e14121040-netizen/2026-NCKU-ME-PROJECT/取物機器人(八足Jansen)/README.md

# 取物機器人（八足 Theo Jansen）

> 本目錄包含八足 Theo Jansen 連桿取物機器人的全部資料。

## 系統架構

```
手機遙控 App（ESP32 內建藍牙）
    │
    ▼
ESP32（主控板，USB 插電腦供電）── 藍牙接收 + ESP-NOW 指令分發中心
    │
    ├── ESP-NOW ──→ ESP32-C3 #1（腿部子控板）
     │                 └── BTS7960 ×2 → JGB37-555 DC 12V 66rpm 直流減速馬達 ×2
     │                                 （左右側八足步行，原地旋轉轉向）
    │
    ├── ESP-NOW ──→ ESP32-C3 #2（RotatingArm 旋轉端）
    │                 ├── MG996R 360°（r 齒條伸縮，人眼判斷位置）
    │                 ├── MG996R 180°（夾爪 θ 旋轉）
    │                 ├── MG996R 180°（夾爪開合）
    │                 └── BTS7960 #4 → JGY370（z 方向升降，蝸桿自鎖）
    │
    └── ESP-NOW ──→ ESP32-C3 #3（FixedStage 固定端）
                      ├── BTS7960 #3 → XD-25GA 370（固定端 spin）
                      └── MG996R 180°（承物盒 Gate）

    電源（機器人上）：
    ├── 上半部 4S：C3 #2 + BTS7960 #4 + z 馬達 + 上方 Servo ×3
    └── 腿部 + FixedStage 4S：C3 #1/#3 + BTS7960 #1/#2/#3 + 腿部馬達 + 固定端 spin + Gate servo

    ESP32 主控板：USB 插電腦獨立供電（ESP-NOW 無線通訊）
```

透過 ESP-NOW 讓各個 ESP 控制板之間不需 Wi-Fi 即可做點對點通訊，在功能上設計模組化的系統。  
**主控板不直接驅動任何馬達**，僅負責藍芽指令接收與 ESP-NOW 指令分發，插電腦 USB 供電。

## 步行機構

- **類型**：Theo Jansen Linkage 八足（Spider Robot）
- **步態**：交替步態（Alternating Gait）— 同側每足相位差 90°，左右側錯開 180°
- **驅動**：左右各 1 顆 JGB37-555 DC 12V 66rpm 直流減速馬達，原地旋轉轉向（不做左右輪不同速轉彎，避免重心不穩）
- **控制**：由 ESP32-C3 #1（腿部子控板）透過 BTS7960 ×2 驅動
- **連桿參數**：Theo Jansen 11 Holy Numbers（縮放因子 0.7）

詳細連桿設計請見 → [TheoJansen連桿設計參考.md](機構設計/TheoJansen連桿設計參考.md)

## 八足配置

```
  俯視圖（↑ = 前進方向）

       前
  足1 ── 足5
   |      |
  足2 ── 足6     ← 機身
   |      |
  足3 ── 足7
   |      |
  足4 ── 足8
       後

  左側（足1~4）→ 馬達 A  ┐
  右側（足5~8）→ 馬達 B  ┘ 由 ESP32-C3 #1 控制
```

## 夾取機構

### 設計概念

- **座標系統**：採用圓柱座標系（r, θ, z），降低設計複雜度同時保留足夠的自由度
- **傳動方式**：齒輪、齒條與馬達控制
- **設計目標**：重量減輕，採用角度夾爪

### 自由度配置

| 自由度 | 驅動元件 | 控制方式 | 控制板 |
|---|---|---|---|
| **r（伸縮）** | MG996R 360° + 齒條 | 人眼判斷，按住伸出/縮回 | C3 #2 |
| **θ（旋轉）** | MG996R 180° | PWM 角度控制 | C3 #2 |
| **z（升降）** | JGY370 蝸桿馬達 | BTS7960 #4，蝸桿自鎖防滑 | C3 #2 |
| **FixedStage spin** | XD-25GA 370 | BTS7960 #3，自鎖 | C3 #3 |
| **夾爪開合** | MG996R 180° | PWM 角度控制 | C3 #2 |

### 機構規格

- **夾爪類型**：齒輪齒條雙向平行夾爪 (Rack and Pinion) — 平行版 + 止滑墊
- **設計參考**：
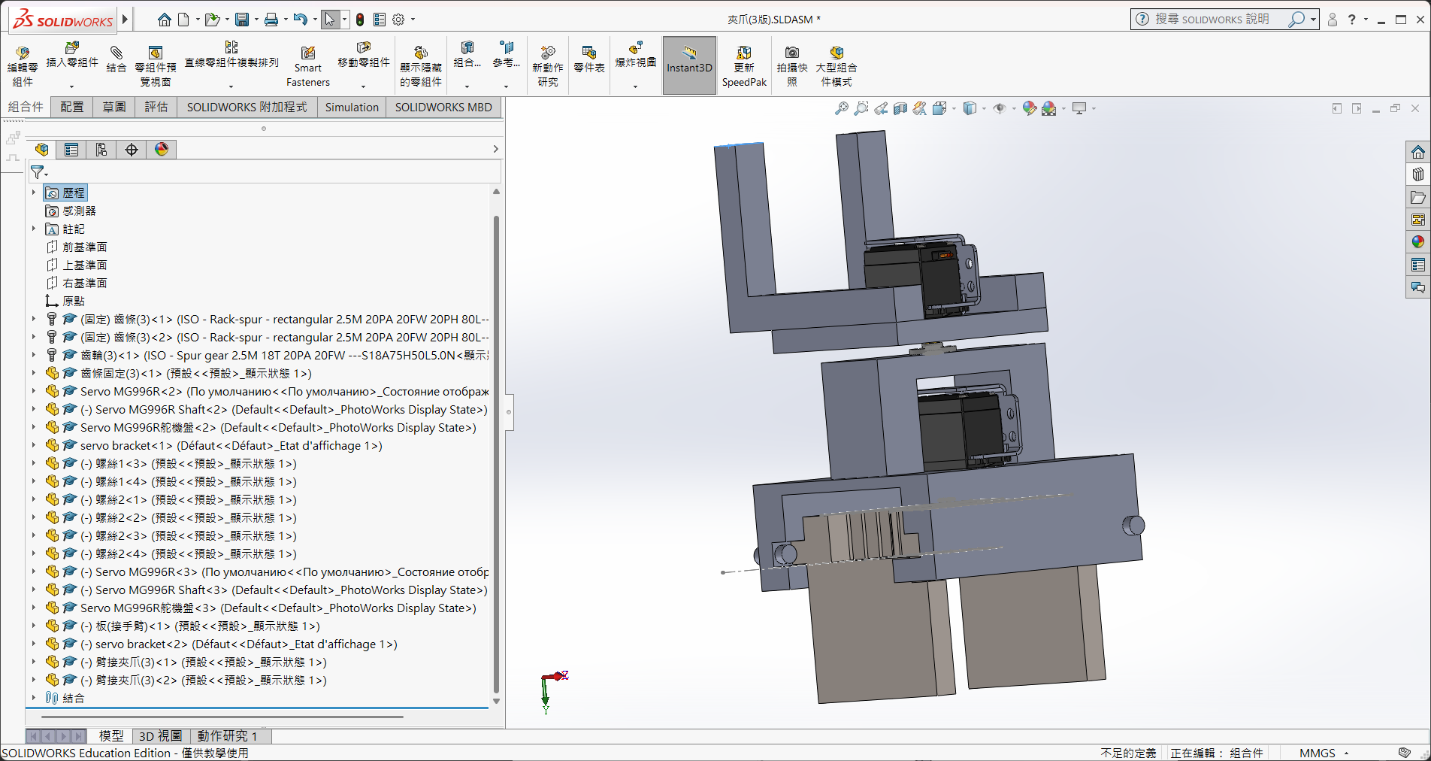
[picture p1: 取物機器人(八足Jansen)/夾爪/image.png]
夾爪設計圖1
  - 
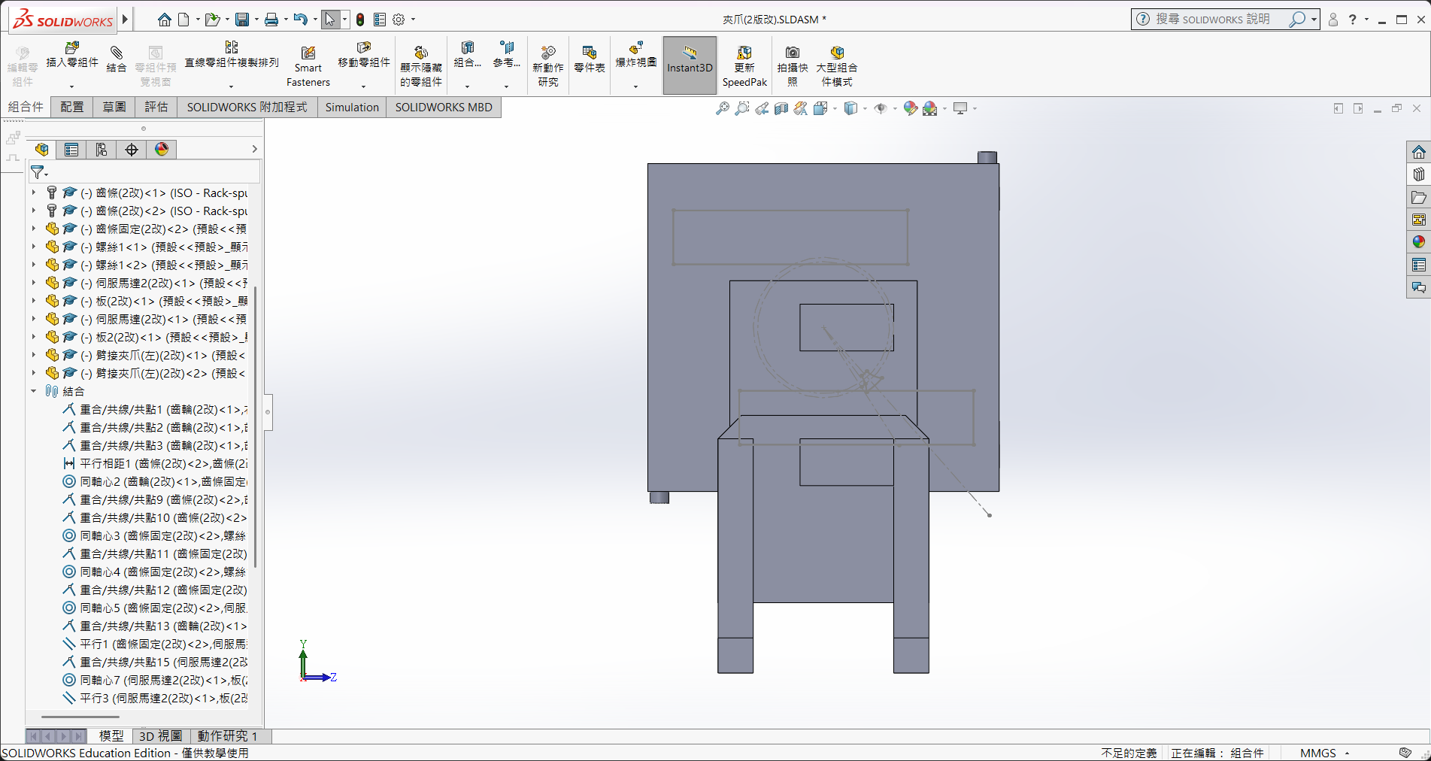
[picture p2: 取物機器人(八足Jansen)/夾爪/2026-03-14_003610.png]
夾爪設計圖2
  - 
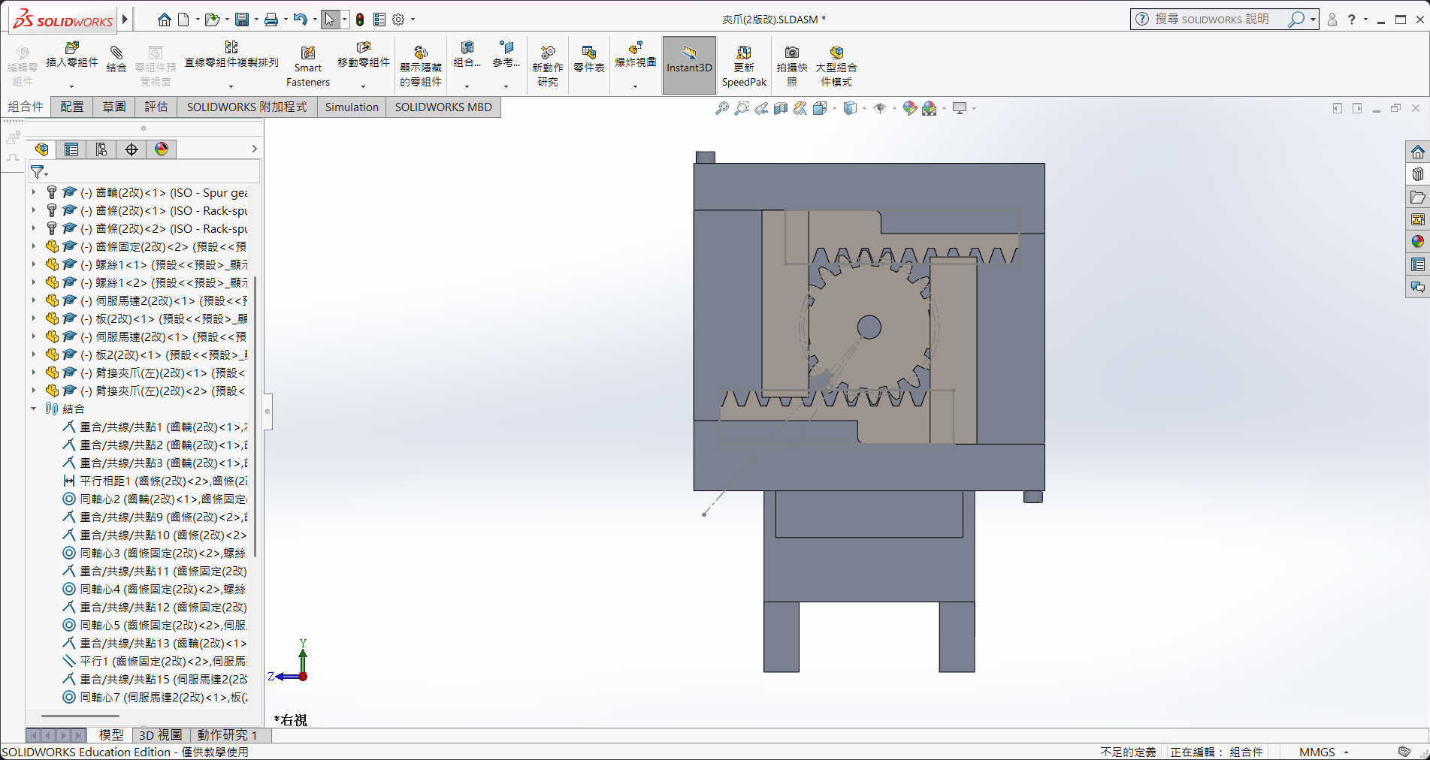
[picture p3: 取物機器人(八足Jansen)/夾爪/2026-03-14_003706.png]
夾爪設計圖3
  - 
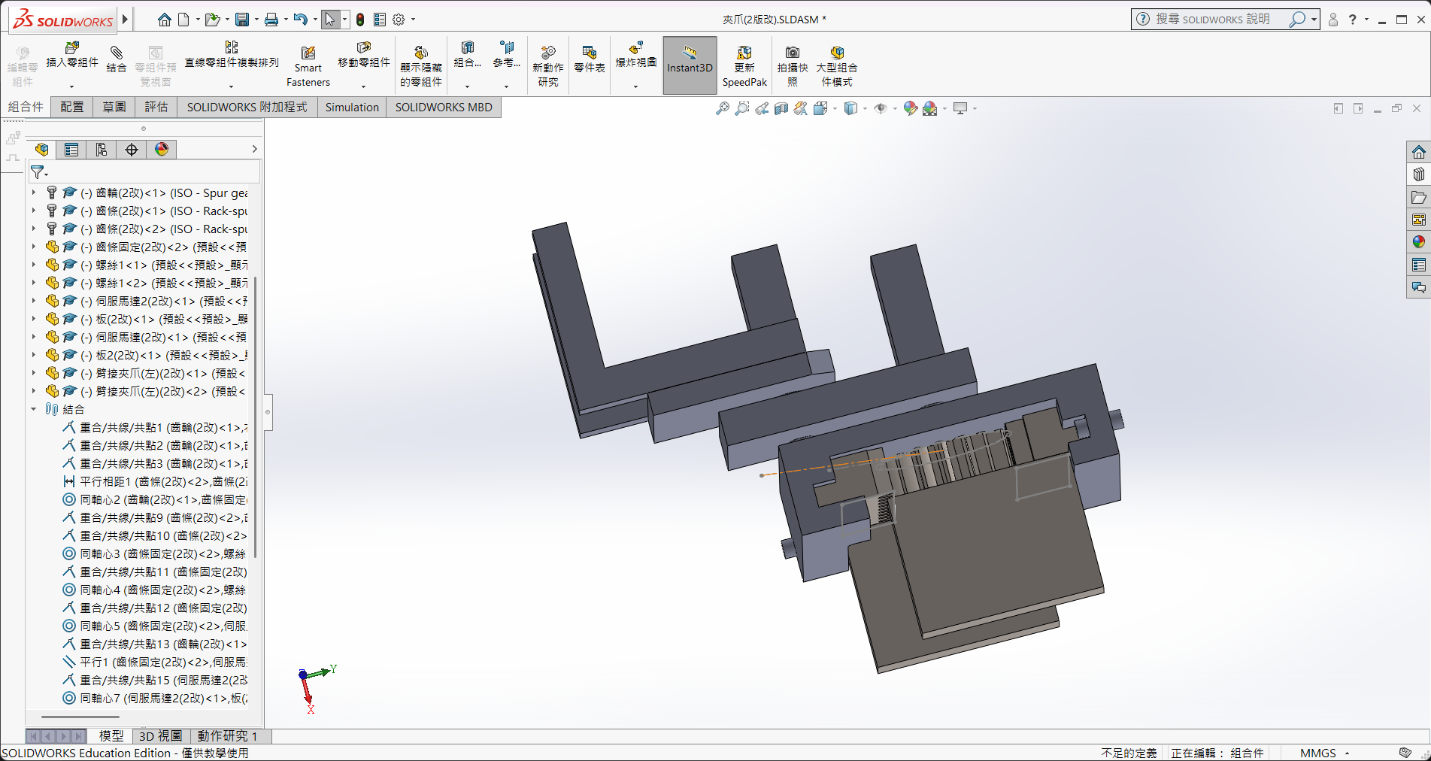
[picture p4: 取物機器人(八足Jansen)/夾爪/2026-03-14_003757.png]
夾爪設計圖4
  - 
- **機構設計**：
  - **夾爪本體**：使用 3D 列印製作夾爪板與溝槽板，齒輪採用壓克力雷射切割，齒條另外採購。
  - **r 方向伸縮**：MG996R 360° 連續旋轉舵機驅動齒條，搭配直線滑軌導引。
  - **固定端 spin**：固定端暫存盒 / 平台由 XD-25GA 370 驅動，提供 right/left 旋轉。
- **驅動設計**：
  - **r 伸縮**（C3 #2）：MG996R 360° 驅動齒條，操作員人眼判斷位置，按住按鈕伸出/縮回、放開停止。軟體超時保護（5 秒）防止過行程。
  - **θ 旋轉**（C3 #2）：MG996R 180° 標準伺服，精確角度控制。
  - **z 方向升降**（C3 #2）：JGY370 蝸桿減速馬達，由 BTS7960 #4 控制正反轉。蝸桿自鎖，斷電不會下滑。
  - **FixedStage spin**（C3 #3）：XD-25GA 370 自鎖馬達，由 BTS7960 #3 控制正反轉。
  - **夾爪開合**（C3 #2）：MG996R 180° 標準伺服，由 C3 GPIO PWM 直接驅動。
  - **安全保護機制**：軟體設有 Maximum Timeout（最大通電時間，預設 5 秒）保護，超時自動停止馬達，防止過行程或卡死燒毀。
- **貨架高度限制**：置物盤底部 156mm、邊框高 200mm → 手臂需伸入此高度。
- **夾取物限制**：最重零件為線性襯套 83.3g、最大外徑 32mm → 夾爪開口需大於 32mm，且馬達扭力需能支撐。

## 整體結構

- **分兩層設計**：
  - 上層：夾爪 + 機械手臂
  - 下層：承物台（堆高機）— 用於暫存取下的零件
- **承物台**：可傾斜式（一側絞鏈、一側伸縮桿），由 ESP32-C3 #3 的伺服馬達控制
- **承物盒擋板**：MG996R 180° 旋轉門式擋板，由 C3 #3 GPIO 5 控制開合
- **目標**：希望一次處理兩筆訂單（取多個零件後一次傾倒）

## 目錄結構

```
取物機器人(八足Jansen)/
├── README.md              ← 本文件
├── BOM.md                 ← 零件清單與預算
├── app_inventor/
│   ├── App指令對照表.md    ← 藍芽指令對照
│   └── AppInventor開發指南.md ← App 開發教學
├── 電控/
│   ├── 接線圖.md          ← 完整接線參考（含線材規格）
│   ├── 電源預算.md        ← 電流計算、電池續航、線材載流量
│   └── 電控組裝SOP.md     ← 分步組裝流程與驗證檢查點
├── 機構設計/
│   └── TheoJansen連桿設計參考.md  ← 連桿理論與尺寸
└── 夾爪/                  ← 夾爪設計圖片
```

> **ESP32 控制程式**統一放在 [`../esp32控制/`](../esp32控制/README.md)

## 快速開始

1. 閱讀 [BOM.md](BOM.md) 確認零件
2. 閱讀 [電控/接線圖.md](電控/接線圖.md) 完成接線
3. 閱讀 [esp32控制/README.md](../esp32控制/README.md) 了解程式架構與上傳流程
4. 上傳 ESP32 主控程式（`01_MainController`）
5. 上傳 ESP32-C3 子控板程式（`02_LegController` / `03_TurntableZController` / `04_ServoClawController`）
6. 設定 ESP32 藍芽遙控 App（參考 [App指令對照表](app_inventor/App指令對照表.md)）
7. 測試 ESP-NOW 三路通訊與步行、手臂、夾爪控制

## 藍芽指令速查

### 腿部指令（→ C3 #1）

| 指令 | 功能 | 指令 | 功能 |
|---|---|---|---|
| `f` | 前進 | `F` | 半速前進 |
| `b` | 後退 | `B` | 半速後退 |
| `l` | 原地左旋 | `L` | 半速左旋 |
| `r` | 原地右旋 | `R` | 半速右旋 |
| `q` | 原地左旋 | `e` | 原地右旋 |
| `0` | 全部停止 | | |

> ⚠ `l`/`r` 與 `q`/`e` 功能相同（皆為原地旋轉），不做左右輪不同速轉彎以避免重心不穩。

### RotatingArm 指令（→ C3 #2）

| 指令 | 功能 | 指令 | 功能 |
|---|---|---|---|
| `w` | r 齒條伸出 | `s` | r 齒條縮回 |
| `x` | r 齒條停止 | `h` | 歸位 |
| `i` | θ 旋轉（正） | `k` | θ 旋轉（反） |
| `o` | 夾爪張開 | `p` | 夾爪閉合 |
| `u` | z 上升 | `j` | z 下降 |

### FixedStage 指令（→ C3 #3）

| 指令 | 功能 | 指令 | 功能 |
|---|---|---|---|
| `a` | 固定端 spin left | `d` | 固定端 spin right |
| `g` | 擋板打開 | `n` | 擋板關閉 |

> 詳細指令協議請見 → [esp32控制/README.md](../esp32控制/README.md)
