e14121040-netizen/2026-NCKU-ME-PROJECT/開發步驟指南.md

# 開發步驟指南 — 機器人專題

> 本文件是整個專案的 **開發流程指南**。  
> 按照以下 8 個階段逐步完成，每個階段都有明確的步驟和驗收標準。

---

## 階段 0：環境準備與採購

### 目標
確保所有軟體已安裝、零件已到貨。

### 步驟

1. **安裝開發環境**
   | 軟體 | 用途 | 下載連結 |
   |------|------|----------|
   | Arduino IDE 2.x **或** PlatformIO | 取物機器人 ESP32 程式 | [Arduino IDE](https://www.arduino.cc/en/software) / [PlatformIO](https://platformio.org/) |
   | BLE Controller – Arduino ESP32 | 遙控 App | 取物機器人正式手機控制端 |
   | VS Code + EV3 MicroPython 擴充 | EV3 程式 | [pybricks.com](https://pybricks.com/ev3-micropython/) |
   | Python 3 + matplotlib | 連桿可視化 | `pip install matplotlib numpy` |
   | SolidWorks / Fusion 360 | 3D 建模 | 學校授權版 |

2. **安裝 ESP32 開發環境**
   - **Arduino IDE**：工具 → 開發板管理員 → 搜尋 `ESP32` → 安裝 Espressif Systems ESP32 Board
   - **PlatformIO**：安裝 PlatformIO IDE 擴充 → 建立 ESP32 專案
   - 需安裝：
   - `WiFi`、`esp_now`（ESP-NOW 通訊，已內建）
   - `BluetoothSerial`（藍芽序列通訊，已內建）
   - `ESP32Servo`（ESP32-C3 #3 伺服馬達控制，需安裝）

3. **採購零件**
   參考 BOM 清單：
   - 取物機器人 → [`取物機器人(八足Jansen)/BOM.md`](取物機器人(八足Jansen)/BOM.md)
   - 運輸機器人 → [`運輸機器人(EV3)/BOM.md`](運輸機器人(EV3)/BOM.md)

4. **準備學長的參考資料**
   - `歷屆學長資料(2021屆)/` 中有學長的 `.aia`（App 原始檔）和 `.ino`（Arduino 程式）
   - 優先閱讀學長的 App 截圖，了解 UI 佈局

### ✅ 驗收標準
- [ ] 所有軟體安裝完成，Arduino IDE 或 PlatformIO 能正常編譯 ESP32 程式
- [ ] BOM 上的零件都已到貨或確認供貨中
- [ ] 學長的 `.aia` 已下載並可在 App Inventor 中開啟

---

## 階段 1：取物機器人 — 底盤機構加工

### 目標
完成八足 Theo Jansen 連桿底盤的實體加工與組裝。

### 前置條件
- 零件已到貨（壓克力板、M3 螺絲、軸承/墊圈）
- 已閱讀 [`TheoJansen連桿設計參考.md`](取物機器人(八足Jansen)/機構設計/TheoJansen連桿設計參考.md)

### 步驟

1. **確認連桿參數**
   - 參考 [`TheoJansen連桿設計參考.md`](取物機器人(八足Jansen)/機構設計/TheoJansen連桿設計參考.md)
   - 確認最終參數：**Theo Jansen 11 Holy Numbers × 縮放因子 0.7**

2. **SolidWorks 繪製連桿片 2D 圖**
   - 畫出曲柄、連桿、搖桿的 2D 輪廓
   - 標注所有孔位（M3 孔徑 3.2mm）
   - 匯出 DXF 供雷射切割

3. **繪製機身底盤**
   - 底盤長 ≈ 280mm、寬 ≈ 260mm
   - 預留馬達座孔位（2 顆直流馬達）
   - 預留手臂底座安裝孔

4. **雷射切割壓克力**
   - 連桿片：3mm 壓克力
   - 底盤：5mm 壓克力（或鋁板）
   - 每面各切 4 組（共 8 足，Theo Jansen 每足多桿件，連桿片數量較多）

5. **組裝八足底盤**
   - 用 M3 螺絲 + 尼龍墊圈當軸銷
   - 先裝一側 4 足，確認轉動順暢
   - 再裝另一側 4 足
   - 同側每足曲柄相位差 90°，左右側錯開 180°（交替步態）

6. **手搖測試**
   - 手動旋轉曲柄，觀察足端軌跡
   - 確認 8 足同步性良好、無卡死

### ✅ 驗收標準
- [ ] 8 足底盤已組裝完成，可手搖運動
- [ ] 足端軌跡為平滑步行路徑（著地段近似直線），確認 Theo Jansen 機構正確
- [ ] 機體尺寸在 400×400mm 限制內

---

## 階段 2：取物機器人 — 電控接線與基礎測試

### 目標
完成所有電路接線，驗證 ESP-NOW 三路通訊與馬達基本功能。

### 前置條件
- 底盤機構已組裝完成（階段 1）
- ESP32 ×1、ESP32-C3 ×3、BTS7960 ×4、XL4015 ×2、LM2596 ×2、電池等零件到貨

> 📋 完整組裝流程請參考 → [`電控/電控組裝SOP.md`](取物機器人(八足Jansen)/電控/電控組裝SOP.md)  
> 📋 電源計算請參考 → [`電控/電源預算.md`](取物機器人(八足Jansen)/電控/電源預算.md)  
> 📋 接線參考 → [`電控/接線圖.md`](取物機器人(八足Jansen)/電控/接線圖.md)

### 步驟 2.1：降壓模組校準

**操作**：
1. 電池盒裝好 4 顆 18650，用三用電表量測電池盒輸出（應為 14~16.8V）
2. 分別接上半部 4S → XL4015-UpperServo、腿部 + FixedStage 4S → XL4015-Gate，**輸出端不接任何負載**
3. 上電，用三用電表量兩顆 XL4015 輸出，轉電位器調至 **5.0V ± 0.1V**
4. 斷電，在兩顆 XL4015 輸出端各焊上 1000μF 電解電容（注意正負極）+ 100nF 陶瓷電容
5. 重複以上步驟校準 LM2596-LegFixed 與 LM2596-Upper 至 5.0V

**驗證**：
- [ ] 電池盒電壓 14.0~16.8V
- [ ] XL4015-UpperServo / XL4015-Gate 輸出 4.9~5.1V（空載）
- [ ] LM2596 輸出 4.9~5.1V（空載）

> ⚠ 電位器通常需要轉很多圈。逆時針降壓、順時針升壓（依型號不同可能相反，看電表讀數調整）。

---

### 步驟 2.2：MCU 供電與上電驗證

**前置**：步驟 2.1 降壓模組已校準

**操作**：
1. LM2596-LegFixed 5V 輸出 → ESP32-C3 #1/#3 的 5V pin（用 24AWG 或杜邦線）
2. LM2596-Upper 5V 輸出 → ESP32-C3 #2 的 5V pin（用 24AWG 或杜邦線）
3. LM2596-LegFixed GND → C3 #1/#3 GND；LM2596-Upper GND → C3 #2 GND
4. 上電，觀察 C3 板載 LED 是否亮起
5. 逐一用 USB 線接電腦，開 Serial Monitor 確認有輸出

**驗證**：
- [ ] 3 塊 C3 板載 LED 正常亮起
- [ ] 腿部 + FixedStage 組內 GND 共地、上半部組內 GND 共地；兩組電源正極沒有互接
- [ ] Serial Monitor 可收到輸出（確認 USB CDC On Boot: Enabled）

---

### 步驟 2.3：取得 MAC 地址並配置

**操作**：
1. 將 `esp32控制/00_macaddress/` 上傳至每塊 C3（一塊一塊來）
2. 記錄 3 塊 C3 的 MAC 地址
3. 打開 `01_MainController.ino`，將 MAC 填入對應欄位：
   ```cpp
   uint8_t Leg_Address[]        = {0x__, 0x__, 0x__, 0x__, 0x__, 0x__};  // C3 #1
   uint8_t turntableZ_Address[] = {0x__, 0x__, 0x__, 0x__, 0x__, 0x__};  // C3 #2
   uint8_t servoClaw_Address[]  = {0x__, 0x__, 0x__, 0x__, 0x__, 0x__};  // C3 #3
   ```

**驗證**：
- [ ] 3 個 MAC 已記錄且填入 MainController 原始碼
- [ ] MAC 格式正確（6 個 0x__ 的 byte）

---

### 步驟 2.4：C3 #1 腿部馬達接線與獨立測試

**前置**：步驟 2.2 C3 已可上電

**操作**：
1. 電池 → BTS7960 #1/#2 (B+/B-)，確認 R_EN/L_EN 已接 3.3V
2. C3 #1 GPIO → BTS7960 #1/#2（RPWM/LPWM），參考接線圖
3. BTS7960 #1 M+/M- → JGB37-555 DC 12V 66rpm 左馬達，BTS7960 #2 M+/M- → 右馬達
4. 上傳 `02_LegController.ino` 至 C3 #1
5. Serial Monitor 測試：`f`(前進) → `b`(後退) → `l`(原地左旋) → `r`(原地右旋) → `0`(停止)
6. 如果馬達方向反了，交換 BTS7960 M+/M- 的兩條馬達線

**驗證**：
- [ ] 前進時兩馬達同向正轉
- [ ] 後退時兩馬達同向反轉
- [ ] 原地左旋/右旋正確（左反右正/左正右反）
- [ ] `+`/`-` 可調速，`0` 可停止

> 常見問題：馬達不轉 → 99% 是 BTS7960 R_EN/L_EN 未接 3.3V。

---

### 步驟 2.5：C3 #2 旋轉端 RotatingArm 接線與獨立測試

**操作**：
1. C3 #2 裝在旋轉端上方機構，控制 r 齒條、θ、夾爪與 z 升降。
2. C3 #2 GPIO 0/1/5 → 上方 Servo ×3 信號線；GPIO 3/4 → BTS7960 #4（z 升降 RPWM/LPWM）。
3. BTS7960 #4 M+/M- → JGY370（z 升降）。
4. 上傳 `03_RotatingArmController.ino` 至 C3 #2。
5. Serial 測試：`w`(r 伸) → `s`(r 縮) → `x`(r 停) → `i`/`k`(θ) → `o`/`p`(爪) → `u`(z 升) → `j`(z 降) → `0`(停)。
5. 輸入 `?` 查看狀態

**驗證**：
- [ ] r 齒條伸縮正常，`RSTOP` 只停止 r 齒條
- [ ] θ 與夾爪 Servo 正常
- [ ] z 升降正常，蝸桿自鎖（斷電不下滑）
- [ ] 持續運轉 5 秒後超時保護觸發
- [ ] 跨旋轉中心的供電線有鬆弛線圈與 strain relief

---

### 步驟 2.6：C3 #3 固定端 FixedStage 接線與獨立測試

**操作**：
1. C3 #3 留在固定端 / 暫存盒側。
2. C3 #3 GPIO 0/1 → BTS7960 #3（固定端 spin RPWM/LPWM）。
3. BTS7960 #3 M+/M- → XD-25GA 370（固定端 spin right/left）。
4. C3 #3 GPIO 5 → Gate servo 信號線；Gate servo V+ 從 XL4015-Gate 5V 取電。
5. 上傳 `04_FixedStageController.ino` 至 C3 #3。
6. Serial 測試：`a`(spin left) → `d`(spin right) → `g`(Gate open) → `n`(Gate close) → `0`(停)。

**驗證**：
- [ ] 固定端 spin 左右轉正常，方向正確
- [ ] Gate Open / Close 正常，Open 後短暫保持再釋放 PWM
- [ ] Gate Close 後 PWM 維持輸出，零件推擠時不會被打開
- [ ] `0` 可停止固定端 spin 與 Gate
- [ ] spin 持續運轉 5 秒後超時保護觸發

> ⚠ Gate servo 供電不足會導致抖動或嗡嗡聲。確認 XL4015-Gate 輸出穩定 5V，且 GND 與 C3 #3 / 腿部 + FixedStage 共地。

---

### 步驟 2.7：主控板 ESP-NOW + BLE 測試

**前置**：步驟 2.3 MAC 已填入，步驟 2.4~2.6 子控板已通過獨立測試

**操作**：
1. 上傳 `01_MainController.ino` 至 ESP32 主控板（USB 接電腦）；Arduino IDE 的 `Partition Scheme` 選 `Huge APP`，CLI 使用 `esp32:esp32:esp32:PartitionScheme=huge_app`
2. 開 Serial Monitor，確認 `Peer added: C3#1 Leg` 等三行輸出
3. Serial 輸入 `f` → 觀察 C3 #1 馬達前進
4. Serial 輸入 `u` → 觀察 C3 #2 z 上升
5. Serial 輸入 `w` → 觀察 C3 #2 齒條伸出
6. Serial 輸入 `a` → 觀察 C3 #3 固定端 spin left
7. Serial 輸入 `0` → 觀察三路全停
8. 手機搜尋 BLE 裝置 `ESP32_MainController` 並連線
9. 用手機 App 發送指令，確認三路回應

**驗證**：
- [ ] ESP-NOW 三路 Peer 全部加入成功
- [ ] 腿部/RotatingArm/FixedStage 三路指令都能正確轉發
- [ ] `0` 全停指令同時停止三路
- [ ] BLE 連線穩定
- [ ] BLE 斷線時自動急停

> 偵錯：如果 ESP-NOW 不通，參考 [`esp32控制/README.md`](esp32控制/README.md) 的「ESP-NOW 通訊偵錯」章節。

---

### 步驟 2.8：全系統聯調

**操作**：
1. 用 App 同時操作步行 + 手臂動作，確認不互相干擾
2. 連續操作 5 分鐘，觀察穩定性
3. 量測電池電壓（操作後應 > 13V）
4. 觸摸 BTS7960 散熱片，確認 < 40°C
5. 記錄任何異常現象

**驗證**：
- [ ] 步行 + 手臂可同時操作
- [ ] ESP-NOW 三路延遲 < 0.5 秒
- [ ] 無突然斷電或 MCU 重啟
- [ ] BTS7960 溫度合理
- [ ] 電池續航 > 15 分鐘

### ✅ 階段 2 總驗收標準
- [ ] C3 #1 腿部：步行馬達前進/後退/原地旋轉均正常
- [ ] C3 #2 RotatingArm：r 齒條、θ、夾爪、z 升降動作正常，超時保護有效
- [ ] C3 #3 FixedStage：固定端 spin 與 Gate 均正常，超時保護有效
- [ ] XL4015-UpperServo / XL4015-Gate / LM2596-LegFixed / LM2596-Upper 輸出穩定 5.0V
- [ ] ESP-NOW 三路通訊穩定，指令延遲 < 0.5 秒
- [ ] BLE 藍芽連線穩定
- [ ] 電池續航 > 15 分鐘

---

## 階段 3：取物機器人 — App 遙控

### 目標
完成手機遙控 App，可控制步行、RotatingArm 與 FixedStage（透過主控板 ESP-NOW 分發）。

### 前置條件
- ESP-NOW 三路通訊已成功測試（階段 2）

### 步驟

1. **配置 BLE Controller – Arduino ESP32**
   - 正式手機控制端使用 **BLE Controller – Arduino ESP32**
   - 連線目標為 BLE 裝置 `ESP32_MainController`
   - 介面包含：
     - **步行控制區**：`FORWARD` / `BACKWARD` / `LEFT` / `RIGHT` / `LEGSTOP`（→ C3 #1）
     - **旋轉端上方機構區**：`UP` / `DOWN` / `EXTEND` / `RETRACT` / `RSTOP` / `THETA+` / `THETA-` / `OPEN` / `CLOSE` / `HOME` / `ARMSTOP`（→ C3 #2）
     - **固定端暫存盒 / spin 區**：`TL` / `TR` / `GATEOPEN` / `GATECLOSE` / `FIXEDSTOP`（→ C3 #3）
     - **全域急停**：`STOP`

2. **測試 App**
   - 腿部動作後以 `LEGSTOP` 驗證只停止 C3 #1
   - 旋轉端動作後以 `ARMSTOP` 驗證只停止 C3 #2（舊 App 的 `TZSTOP` / `SERVOSTOP` 也會停 C3 #2）
   - 固定端動作後以 `FIXEDSTOP` 驗證只停止 C3 #3
   - 最後以 `STOP` 驗證三路急停
   - 視需要加上 `SPD:xxx` 作為進階速度設定
   - 確認指令正確分發到對應子控板

3. **安裝到手機**
   - 將 App 安裝到操作員的 Android 手機

### ✅ 驗收標準
- [ ] App 可穩定連線 ESP32 藍芽
- [ ] 步行按鈕正常（→ C3 #1 回應）
- [ ] RotatingArm 按鈕正常（→ C3 #2 回應）
- [ ] FixedStage 按鈕正常（→ C3 #3 回應）
- [ ] 按鈕夠大，操作流暢

---

## 階段 4：取物機器人 — 手臂機構整合

### 目標
完成機械手臂的設計、組裝，並與底盤整合。

### 前置條件
- 底盤步行系統已完成（階段 1 + 2）
- App 遙控已完成（階段 3）

### 步驟

1. **設計手臂結構**
   - 圓柱座標系（r, θ, z）+ 大圓盤 + 夾爪開合
   - r 方向：MG996R 360° + 齒條 + 直線滑軌
   - θ 方向：MG996R 180°
   - z 方向：JGY370 蝸桿馬達（自鎖）
   - 大圓盤：XD-25GA 370（自鎖）
   - 夾爪開合：MG996R 180°
   - SolidWorks 建模，確認活動範圍

2. **加工手臂零件**
   - 3D 列印或壓克力切割
   - 組裝手臂，用手動測試活動範圍

3. **安裝到底盤**
   - 固定手臂底座到底盤前方
   - 確認手臂重心不會讓機器人翻倒

4. **調整 Servo 參數**
   - 修改 C3 #3 程式中的角度設定：
     ```cpp
     const int CLAW_OPEN = 40;      // 依夾爪間距調整
     const int CLAW_CLOSE = 110;
     const int THETA_MIN = 0;       // 依實際機構調整
     const int THETA_MAX = 180;
     ```
   - 反覆測試，直到夾取動作順暢
   - 確認 r 齒條超時保護有效（運轉 5 秒後自動停止 360° Servo）

5. **完整功能測試**
   - App 操控步行（C3 #1）→ 大圓盤對位（C3 #2）→ z 下降（C3 #2）→ 齒條伸出與夾取（C3 #3）→ 放置
   - 確認步行、Turntable/Z 與 Servo 可同時操作（不互相干擾）

### ✅ 驗收標準
- [ ] 手臂可從貨架高度夾取零件
- [ ] 夾爪伺服夾持力足夠，零件不掉落
- [ ] 步行（C3 #1）+ Turntable/Z（C3 #2）+ Servo/夾爪（C3 #3）可同時操作（不互相干擾）
- [ ] 整機重心穩定，行走不翻倒

---

## 階段 5：運輸機器人 — EV3 組裝與程式

### 目標
完成 EV3 運輸機器人的組裝和程式調校。

### 前置條件
- EV3 套件已借到
- 已閱讀 [`運輸機器人(EV3)/README.md`](運輸機器人(EV3)/README.md)

### 步驟

1. **組裝 EV3 底盤**
   - 參考 [`EV3組裝設計參考.md`](運輸機器人(EV3)/機構設計/EV3組裝設計參考.md)
   - 安裝雙大馬達（Port D + C）
   - 安裝顏色感測器（Port S1）+ 觸碰感測器（Port S4）

2. **組裝輸送帶機構**
   - 用中馬達（Port A）驅動頂部水平輸送帶
   - 到達放置區後啟動輸送帶將零件推落至平台

3. **部署程式**
   - 將 `transport_robot.py` 部署到 EV3
   - 使用 VS Code + EV3 MicroPython 擴充套件

4. **PID 循跡調校**
   - 在黑線軌道上測試
   - 調整 `transport_robot.py` 中的 PID 參數：
      ```python
      KP = 0.85      # 目前調校值
      KI = 0.01
      KD = 0.5
      BASE_SPEED = 110
      ```
   - 調校步驟：
     1. 先只調 KP，讓車子能跟著線走（雖然會晃）
     2. 加入 KD，減少晃動
     3. 最後微調 KI，消除穩態誤差

5. **顏色偵測測試**
   - 在軌道上放黃色紙條 → 確認停車 + 執行放置動作
   - 放紅色紙條 → 確認停車等待

### ✅ 驗收標準
- [ ] EV3 可穩定循跡（不出軌）
- [ ] 正確辨識黃色/紅色停止線
- [ ] 輸送帶能將零件全部推落至放置區平台
- [ ] 全程自動完成（不需人為介入）

---

## 階段 6：雙機聯合測試

### 目標
兩台機器人在模擬場地上協同完成任務。

### 前置條件
- 取物機器人完成（階段 1~4）
- 運輸機器人完成（階段 5）

### 步驟

1. **建立模擬場地**
   - 用黑色膠帶在場地鋪設軌跡線
   - 設置黃色放置區和紅色停止線
   - 準備模擬貨架和零件

2. **協同流程演練**
   ```
   取物機器人 app 遙控走到貨架
        → 夾取零件
        → 走到運輸機器人旁
        → 放置零件到運輸機器人
   運輸機器人 自動循跡
        → 行駛到放置區
        → 放置零件
        → 返回起點等待
   ```

3. **計時練習**
   - 記錄每次完整流程的時間
   - 找出瓶頸（通常是取物遙控操作時間）
   - 針對瓶頸優化

4. **故障排除**
   - 常見問題：
      - 藍芽斷線 → 檢查電池電壓、ESP32 天線
      - 循跡不穩 → 重新校正感測器、調 PID
     - 零件掉落 → 調整夾爪角度/力道

### ✅ 驗收標準
- [ ] 雙機聯合完成 1 次完整任務
- [ ] 完成時間 < 目標時間
- [ ] 操作流程清晰，操作員熟練

---

## 階段 7：報告、海報、最終調校

### 目標
完成所有書面資料，準備上台報告。

### 步驟

1. **撰寫報告**（存放在 `文件/報告/`）
   - 計畫書 / 期中報告 / 期末報告
   - 內容包含：動機、設計、實作過程、測試結果

2. **製作海報**（存放在 `文件/海報/`）
   - 海報尺寸依課程規定
   - 包含系統架構圖、實物照片、測試數據

3. **製作影片**
   - 海報 + 影片合佔成績 **5%**
   - 內容建議：機器人運作展示、設計理念、測試成果

4. **最終調校**
   - 確定比賽用的 PID 參數
   - 確定手臂角度參數
   - 全速度測試
   - 電池充滿

5. **準備備品**
   - 備用電池
   - 備用螺絲/墊圈
   - 備用伺服馬達
   - 工具箱（螺絲起子、鉗子等）

### ✅ 驗收標準
- [ ] 報告已繳交
- [ ] 海報已完成
- [ ] 備品齊全
- [ ] 全隊模擬演練至少 3 次

---

## 時間線（對齊課程進度表）

> ❗ **繳交截止時間**：
> - 會議紀錄：每週五 17:00
> - 專題計劃書：2026/04/02 (四) 17:00
> - 期中報告：2026/05/15 (五) 17:00
> - 期末報告：2026/06/26 (五) 17:00

| 週次 | 日期 | 階段 | 主要工作 | 📌 繳交 |
|---|---|---|---|---|
| Week 1~2 | 2/24 ~ 3/3 | 階段 0 | 分組、環境準備、概念設計 | |
| Week 3~4 | 3/10 ~ 3/17 | 階段 0~1 | 馬達選用、連桿設計、採購 | |
| Week 5 | 3/24 | 階段 1 | 加工、組裝啟動 | |
| Week 6 | 3/31 | 階段 1 | 底盤完成 | |
| | **4/2 (四)** | | | **📌 專題計劃書 17:00** |
| Week 7 | 4/7 | 階段 2 | 電控接線（🌸 春假週） | |
| Week 8 | 4/14 | 階段 2~3 | 電控完成、App 開發 | |
| Week 9 | 4/21 | 階段 3~4 | App 完成、手臂設計 | |
| Week 10 | 4/28 | 階段 4 | 手臂整合 | |
| Week 11 | 5/5 | 階段 5~6 | EV3 完成、首次聯合測試 | |
| Week 12 | 5/12 | 階段 6 | 聯合測試、問題修正 | |
| | **5/15 (五)** | | | **📌 期中報告 17:00** |
| Week 13~14 | 5/19 ~ 5/26 | 階段 6 | 反覆測試、優化 | |
| Week 15~16 | 6/2 ~ 6/9 | 階段 7 | 報告、海報、最終調校 | |
| Week 17 | 6/15 | — | **🏆 各班期末競賽** | **📌 期末競賽** |
| Week 18 | 6/22 | — | 收尾 | |
| | **6/26 (五)** | | | **📌 期末報告 17:00** |
| 6/27 (六) | | — | **實作展**（前 50% 參賽） | |

> **提示**：EV3 組裝（階段 5）可在 Week 5 起與取物機器人（階段 1~4）**同時進行**，由不同組員負責。
