e14121040-netizen/2026-NCKU-ME-PROJECT/開會紀錄/0331.md

# 會議紀錄 — 0331

> **日期**：2026 / 03 / 31  
> **出席**：（請補充出席人員）  
> **主持**：  
> **記錄**：

---

## 議程

1. 底盤組裝進度確認
2. ESP32 控制架構升級
3. 專題計劃書收尾

## 討論內容

### 1. 底盤組裝進度

- （請補充實際討論內容）

### 2. ESP32 控制架構升級

- 確認升級為 3×ESP32-C3 分散式架構
- 腿部馬達獨立至 C3 #1 子控板
- 移除 PCA9685 改為 GPIO PWM 直接驅動伺服
- 通訊改用 ESP-NOW 協議

### 3. 專題計劃書

- 計劃書截止日：4/2 (四) 17:00
- 各章節確認與分工

## 工作分配 / 待辦事項

| 負責人 | 事項 | 截止日 |
|---|---|---|
| （請補充） | 專題計劃書最終定稿 | 4/2 |
| （請補充） | ESP32 電控架構文件更新 | 4/7 |

## 下次開會

- **日期**：2026/04/07
- **議程預告**：春假週進度回報、L298N 接線測試
