e14121040-netizen/2026-NCKU-ME-PROJECT/開會紀錄/0407.md

# 會議紀錄 — 0407

> **日期**：2026 / 04 / 07（春假週）  
> **出席**：（請補充出席人員）  
> **主持**：  
> **記錄**：

---

## 議程

1. 春假週實作進度
2. L298N 接線測試
3. ESP32 藍芽測試

## 討論內容

### 1. 春假週進度

- （請補充實際討論內容）

### 2. L298N + 馬達接線

- L298N 驅動板 ENA/ENB 跳線帽確認拔除
- 直流馬達方向測試
- （請補充測試結果）

### 3. ESP32 藍芽連線

- ESP32 BluetoothSerial 版基本連線測試
- 手機配對測試
- （請補充測試結果）

## 工作分配 / 待辦事項

| 負責人 | 事項 | 截止日 |
|---|---|---|
| （請補充） |  |  |

## 下次開會

- **日期**：2026/04/14
- **議程預告**：電控完成確認、App 開發啟動
