e14121040-netizen/2026-NCKU-ME-PROJECT/開會紀錄/0414.md

# 會議紀錄 — 0414

> **日期**：2026 / 04 / 14  
> **出席**：（請補充出席人員）  
> **主持**：  
> **記錄**：

---

## 議程

1. ESP32 分散式架構實作進度
2. C3 #2 手臂控制測試
3. 文件同步更新

## 討論內容

### 1. ESP32 分散式架構

- ESP-NOW 三路通訊架構已建立
- MainController (BluetoothSerial 版) 完成指令分發
- LegController (C3 #1) 腿部控制已可動作
- ESP32-C3 #1 腿部子控板連線修改 (v1)

### 2. C3 #2 手臂控制

- noah_夾爪控制測試.ino 已開發
- r/θ 軸 DC 馬達 L298N 驅動測試
- 限位開關安全保護邏輯已加入
- （請補充測試結果）

### 3. 文件更新

- 接線圖更新為 3 板架構
- BOM 同步更新
- README 文件同步

## 工作分配 / 待辦事項

| 負責人 | 事項 | 截止日 |
|---|---|---|
| （請補充） | C3 #3 z/夾爪程式開發 | 4/21 |
| （請補充） | BLE 版主控板測試 | 4/21 |
| （請補充） | App 開發啟動 | 4/21 |

## 下次開會

- **日期**：2026/04/21
- **議程預告**：ZClawController 完成、BLE 版測試、手臂整合準備
