e14121040-netizen/2026-NCKU-ME-PROJECT/取物機器人(八足Jansen)/電控/接線圖.md

# 取物機器人 — 接線圖

> 本文件列出取物機器人所有電路接線。  
> 已更新為 ESP32 + ESP32-C3 ×3 + ESP-NOW 分散式模組化架構。  
> ⚠ **最後更新：2026/06/06** — C3 #2 改為旋轉端 RotatingArm，C3 #3 改為固定端 FixedStage，避免上方夾爪與 z 旋轉時纏線。

## 系統供電架構

```
腿部 + FixedStage 4S 18650（四節串聯 ≈ 14.8V~16.8V，需搭配 4S BMS）
    │
    ├── 【15A 保險絲】── 腿部 + FixedStage 正極端子台（電池→保險絲→端子台主幹 16AWG）
    │                       ├──→ BTS7960 #1 B+（左腿，18AWG）
    │                       ├──→ BTS7960 #2 B+（右腿，18AWG）
    │                       ├──→ BTS7960 #3 B+（固定端 spin，18AWG）
    │                       ├──→ XL4015-Gate IN+（20AWG）
    │                       └──→ LM2596-LegFixed IN+（22AWG）
    │
    └── 腿部 + FixedStage GND 端子台（電池→端子台主幹 16AWG）
                            ├──→ BTS7960 #1 B-（18AWG）
                            ├──→ BTS7960 #2 B-（18AWG）
                            ├──→ BTS7960 #3 B-（18AWG）
                            ├──→ XL4015-Gate IN-（20AWG）
                            ├──→ LM2596-LegFixed IN-（22AWG）
                            └──→ ESP32-C3 #1/#3 GND

    BTS7960 #1 M+/M- → JGB37-555 DC 12V 66rpm 左腿（左側 4 足）
    BTS7960 #2 M+/M- → JGB37-555 DC 12V 66rpm 右腿（右側 4 足）
    BTS7960 #3 M+/M- → XD-25GA 370 固定端 spin right/left

    XL4015-Gate → 5V【Gate servo 專用電源】
        ├── MG996R 180°（承物盒 Gate）── 信號線接 C3 #3 GPIO（固定端）
        └── ⚡ 輸出端並聯 1000μF 電解電容 + 100nF 陶瓷電容

上半部 4S 18650（四節串聯 ≈ 14.8V~16.8V，需搭配 4S BMS）
    │
    ├── 【10A 保險絲】── 上半部正極端子台
    │                       ├──→ BTS7960 #4 B+（旋轉端 z 升降，18AWG，經旋轉中心鬆弛線圈）
    │                       ├──→ XL4015-UpperServo IN+（20AWG）
    │                       └──→ LM2596-Upper IN+（22AWG）
    │
    └── 上半部 GND 端子台
                            ├──→ BTS7960 #4 B-（18AWG）
                            ├──→ XL4015-UpperServo IN-（20AWG）
                            ├──→ LM2596-Upper IN-（22AWG）
                            └──→ ESP32-C3 #2 GND

    BTS7960 #4 M+/M- → JGY370 旋轉端 z 方向升降（12V 蝸桿自鎖）

    XL4015-UpperServo → 5V【上方 Servo 專用電源】
        ├── MG996R 360°（r 齒條伸縮）── 信號線接 C3 #2 GPIO（旋轉端）
        ├── MG996R 180°（夾爪 θ 旋轉）── 信號線接 C3 #2 GPIO（旋轉端）
        ├── MG996R 180°（夾爪開合）── 信號線接 C3 #2 GPIO（旋轉端）
        └── ⚡ 輸出端並聯 1000μF 電解電容 + 100nF 陶瓷電容

    LM2596-LegFixed → 5V【腿部 + FixedStage MCU 專用電源】→ ESP32-C3 #1/#3
    LM2596-Upper → 5V【上半部 MCU 專用電源】→ ESP32-C3 #2

ESP32 主控板 → USB 插電腦供電（獨立電源，透過 ESP-NOW 無線通訊）
```

> ⚠ **重要**：
> - 🔥 **嚴禁使用麵包板 (breadboard) 分配 12V 電源** — 麵包板觸點僅額定 ~1A，會燒毀
> - 🔥 **嚴禁使用杜邦線 (28AWG) 作為電源線** — 杜邦線僅額定 1.4A，僅適用於信號線
> - ✅ 電源分配必須使用**端子台 (terminal block)** + 足夠線徑的矽膠線（腿部主幹 16AWG，BTS7960 分支 18AWG）
> - ✅ 腿部 + FixedStage 電池正極必須串聯 **15A 保險絲**；上半部電池正極必須串聯 **10A 保險絲**
> - ✅ 每組 4 顆 18650 串聯都必須使用 **4S BMS** 或等效保護板，避免過放、過流與充電不平衡
> - Servo 電源（XL4015）與 MCU 電源（LM2596）**必須分開**，避免 Servo 突波造成 ESP32 重啟；上半部 Servo 與 Gate servo 分屬不同電池組，必須使用兩路 5V buck，不要跨組共用同一顆 XL4015
> - C3 #2 RotatingArm、上方 Servo ×3、BTS7960 #4 與 z 馬達都在旋轉端；C3 #3 FixedStage、BTS7960 #3、Gate servo 與暫存盒都在固定端
> - 旋轉端為有限角度（±90° / ±180°）時，跨旋轉關節的供電線請走旋轉中心，預留鬆弛線圈並做 strain relief，不需 slip ring
> - 各電源組內 **GND 必須共地**；上半部 4S 與腿部 + FixedStage 4S 只透過 ESP-NOW 通訊，正式架構下兩組 GND 不需要相接
> - ESP32 主控插電腦時不需與機器人共地（ESP-NOW 是無線通訊）

## 模組化架構概覽

```
                    ┌─────────────────────┐
                    │      筆電 USB        │
                    │                     │
    遙控 App ←─BLE─┤    ESP32 主控板      │
    (手機藍芽)      │  只負責:            │
                    │  ①藍芽接收          │
                    │  ②ESP-NOW 分發      │
                    └───┬───┬───┬─────────┘
                        │   │   │
          ESP-NOW ──────┘   │   └────── ESP-NOW
              │             │               │
              ▼             ▼               ▼
    ┌────────────┐ ┌──────────────┐ ┌──────────────────┐
    │ ESP32-C3   │ │ ESP32-C3     │ │ ESP32-C3         │
    │ #1 腿部    │ │ #2 RotatingArm│ │ #3 FixedStage     │
    │            │ │              │ │                  │
    │ BTS7960 ×2 │ │ Servo ×3     │ │ BTS7960 #3       │
    │ →步行馬達  │ │ r/θ/夾爪      │ │ →固定端 spin      │
    │   ×2       │ │ BTS7960 #4   │ │ Gate servo       │
    │            │ │ →z 升降馬達  │ │ →暫存盒擋板       │
    └────────────┘ └──────────────┘ └──────────────────┘
```

## 電流估算

### 12V 側（電池直供 BTS7960）

| 負載 | 正常電流 | 峰值電流（堵轉） |
|---|---|---|
| JGB37-555 × 2（腿部行走，BTS7960 #1/#2） | ~3.0~4.0A | ~12~16A |
| XD-25GA 370 × 1（固定端 spin，BTS7960 #3） | ~0.5A | ~2A |
| JGY370 × 1（旋轉端 z 升降，BTS7960 #4） | ~0.5A | ~1.5~3A |
| **腿部 + FixedStage 4S 電池組 DC 馬達側** | **~4.0~5.5A** | **~14~18A（極端）** |
| **上半部 4S 電池組 DC 馬達側** | **~0.5A** | **~1.5~3A（極端）** |

### 5V 側 — XL4015（Servo 專用，最大 5A）

| 負載 | 正常電流 | 峰值電流 |
|---|---|---|
| 上方 MG996R Servo ×3（上半部 XL4015-UpperServo） | ~1.5~2.7A | ~7.5A（3 顆同時堵轉） |
| Gate Servo ×1（腿部 + FixedStage XL4015-Gate） | ~0.5~1.0A | ~2.5A（堵轉） |

> ⚠ 避免多顆 Servo 同時堵轉。上半部 Servo ×3 與 Gate servo 分屬不同電池組，兩路 XL4015 的 GND 只在各自電池組內共地，不跨組相接。

### 5V 側 — LM2596（MCU 專用，最大 3A）

| 負載 | 電流 |
|---|---|
| ESP32-C3 #1/#3（腿部 + FixedStage LM2596-LegFixed） | ~0.2A |
| ESP32-C3 #2（上半部 LM2596-Upper） | ~0.1A |
| **MCU 總計** | **~0.3A** ✅ 已分散到兩組 LM2596 |

## ESP32-C3 #1 ↔ BTS7960 ×2（腿部步行馬達）

> **注意**：GPIO 腳位依 ESP32-C3 Super Mini 實際可用 GPIO 分配。
> BTS7960 每個模組只控制 **1 顆馬達**，左右腿各需 1 個模組。

```
ESP32-C3 #1            BTS7960 #1（左腿）
───────────            ──────────────────
GPIO 0 (PWM)     ──→  RPWM ─┐
GPIO 1 (PWM)     ──→  LPWM ─┤── M+/M-：JGB37-555 66rpm（左側 4 足）
3.3V             ──→  VCC
                       R_EN ──→ 接 3.3V（常開）
                       L_EN ──→ 接 3.3V（常開）

ESP32-C3 #1            BTS7960 #2（右腿）
───────────            ──────────────────
GPIO 3 (PWM)     ──→  RPWM ─┐
GPIO 4 (PWM)     ──→  LPWM ─┤── M+/M-：JGB37-555 66rpm（右側 4 足）
3.3V             ──→  VCC
                       R_EN ──→ 接 3.3V（常開）
                       L_EN ──→ 接 3.3V（常開）

GND              ──→  腿部 + FixedStage GND 端子台（與腿部 + FixedStage 電池、LM2596-LegFixed、BTS7960 #1/#2/#3 共地）
```

> **BTS7960 控制原理**：
> - 正轉：RPWM 輸出 PWM duty，LPWM = 0
> - 反轉：RPWM = 0，LPWM 輸出 PWM duty
> - 停止：RPWM = 0，LPWM = 0（馬達浮接）
>
> **R_EN / L_EN 說明**：
> - BTS7960 邏輯側 `VCC` 也要接 C3 的 3.3V，不能只接 R_EN/L_EN
> - 接 3.3V 表示驅動器常開，不佔 GPIO
> - 若未來需要硬體急停功能，可改接 GPIO 控制（拉 LOW = 馬達浮接）

## ESP32-C3 #2 RotatingArm — 旋轉端 Servo ×3 + z 升降

> C3 #2 RotatingArm 固定在會旋轉的上方機構上，避免 r / θ / 夾爪 / z 的控制線跨過旋轉關節。

```
ESP32-C3 #2 RotatingArm     旋轉端 Servo ×3
───────────────────────     ───────────────
GPIO 0 (PWM)          ──→   MG996R 360°（r 齒條伸縮）── 信號線
GPIO 1 (PWM)          ──→   MG996R 180°（夾爪 θ 旋轉）── 信號線
GPIO 5 (PWM)          ──→   MG996R 180°（夾爪開合）── 信號線

ESP32-C3 #2 RotatingArm     BTS7960 #4（旋轉端 z 升降）
───────────────────────     ─────────────────────────
GPIO 3 (PWM)          ──→   RPWM ─┐
GPIO 4 (PWM)          ──→   LPWM ─┤── M+/M-：JGY370（z 方向升降，蝸桿自鎖）
3.3V                  ──→   VCC
                            R_EN ──→ 接 3.3V（常開）
                            L_EN ──→ 接 3.3V（常開）

GND                   ──→   上半部 GND 匯流排
```

> **旋轉端供電線束**：
> - 跨旋轉關節只走必要供電，例如 BTS7960 #4 / Servo / C3 #2 的 12V、5V、GND。
> - 線束請從旋轉中心附近穿過，保留鬆弛線圈，並在固定端與旋轉端都做 strain relief。
> - 目前旋轉角度有限（±90° / ±180°），不需 slip ring。
> - Servo V+（紅線）接 XL4015-UpperServo 5V；Servo GND（棕線）與 C3 #2 GND、XL4015-UpperServo GND、上半部 GND 共地。

> ⚠ **r 齒條安全**：360° Servo 沒有位置回饋，軟體端使用超時保護（預設 5 秒）自動停止，防止齒條過行程。

### C3 #2 GPIO 使用總結

| GPIO | 用途 |
|---|---|
| 0 | MG996R 360° PWM（r 齒條） |
| 1 | MG996R 180° PWM（θ 旋轉） |
| 3 | BTS7960 #4 RPWM（z 上升） |
| 4 | BTS7960 #4 LPWM（z 下降） |
| 5 | MG996R 180° PWM（夾爪開合） |
| 2, 6~10, 20, 21 | 備用 |

## ESP32-C3 #3 FixedStage — 固定端 spin + Gate

> C3 #3 FixedStage 留在固定底座 / 暫存盒側，控制不會跟著上方夾爪旋轉的 spin right/left 與 Gate。

```
ESP32-C3 #3 FixedStage      BTS7960 #3（固定端 spin）
──────────────────────      ─────────────────────────
GPIO 0 (PWM)          ──→   RPWM ─┐
GPIO 1 (PWM)          ──→   LPWM ─┤── M+/M-：XD-25GA 370（固定端 spin right/left）
3.3V                  ──→   VCC
                            R_EN ──→ 接 3.3V（常開）
                            L_EN ──→ 接 3.3V（常開）

ESP32-C3 #3 FixedStage      暫存盒 Gate servo
──────────────────────      ───────────────
GPIO 5 (PWM)          ──→   MG996R（Gate Open / Close）── 信號線

GND                   ──→   腿部 + FixedStage GND 匯流排
```

> **Gate Servo 電源接線**：
> - V+（紅線）──→ XL4015-Gate 5V 輸出（不是 C3 的 3.3V/5V pin）
> - GND（棕線）──→ 共地（XL4015-Gate GND = C3 #3 GND = 腿部 + FixedStage GND）
> - 信號線（橘線）──→ C3 #3 GPIO 5

### C3 #3 GPIO 使用總結

| GPIO | 用途 |
|---|---|
| 0 | BTS7960 #3 RPWM（固定端 spin left） |
| 1 | BTS7960 #3 LPWM（固定端 spin right） |
| 5 | Gate servo PWM |
| 2, 3, 4, 6~10, 20, 21 | 備用 |

## ESP32 ↔ ESP32-C3 ×3（ESP-NOW 通訊）

```
ESP32（主控板，USB 插電腦）
    │
    ├── ESP-NOW（無線點對點）──→ ESP32-C3 #1（腿部）
    ├── ESP-NOW（無線點對點）──→ ESP32-C3 #2 RotatingArm（旋轉端）
    └── ESP-NOW（無線點對點）──→ ESP32-C3 #3 FixedStage（固定端）

主控板功能：                                    子控板功能：
  - 藍芽接收（手機遙控 App）                     #1 - 腳部步行馬達控制（BTS7960 ×2）
  - ESP-NOW 指令分發                             #2 - Servo ×3 + z 升降控制（旋轉端）
  （不直接驅動任何馬達）                          #3 - 固定端 spin + Gate 控制
  （USB 插電腦獨立供電）
```

> **ESP-NOW 特點**：不需 Wi-Fi 路由器，點對點通訊，延遲低，適合即時控制。  
> 需在主控板程式中初始化 ESP-NOW 並註冊三個子控板的 MAC 位址。  
> ESP32 主控板插電腦 USB 供電，與機器人之間完全無線連接。

## 線材規格速查

> 詳細計算請見 → [電源預算.md](電源預算.md)

| 接線段 | 建議 AWG | 最大電流 | 端子類型 |
|---|---|---|---|
| 腿部 + FixedStage 電池 → 15A 保險絲 → 腿部 + FixedStage 端子台 | **16** | 腿部 + FixedStage 合計峰值 | 端子台螺絲 |
| 腿部 + FixedStage 端子台 → BTS7960 #1/#2 B+ | **18** | ~8A 單路峰值 | 端子台螺絲 |
| 腿部 + FixedStage 端子台 → BTS7960 #3 B+ | **18** | ~2A 峰值 | 端子台螺絲 |
| 上半部電池 → BTS7960 #4 B+ | **18** | ~3A 峰值 | 端子台螺絲 |
| 電池 → XL4015/LM2596 IN | 20-22 | ~3A | 焊接/端子台 |
| XL4015 OUT → Servo V+ | **22** | ~5A 峰值 | 焊接 + 杜邦母頭 |
| LM2596 OUT → C3 5V | 24 | ~0.3A | 杜邦線 |
| BTS7960 M+/M- → 腿部 JGB37-555 | **20** | ~8A 峰值 | 端子台螺絲 |
| BTS7960 M+/M- → FixedStage / z DC 馬達 | **20** | ~3A 峰值 | 端子台螺絲 |
| C3 GPIO → BTS7960 RPWM/LPWM | 杜邦(28) | <100mA | 杜邦公母 |
| C3 GPIO → Servo 信號 | 杜邦(28) | <10mA | 杜邦公母 |
| 腿部 + FixedStage 電池 → 腿部 + FixedStage GND 端子台主幹 | **16** | 腿部 + FixedStage 合計電流 | 端子台 |
| 腿部 + FixedStage GND 端子台 → BTS7960 #1/#2/#3 | **18** | ~8A 單路峰值 | 端子台 |
| 上半部 GND 匯流 | **18** | 上半部合計電流 | 端子台 |

> ⚠ **杜邦線（28AWG, ~1.4A）不可用於電源線！** 電源線務必用 16-22AWG 矽膠線，依負載電流選線徑。

## 組裝流程

> 完整分步組裝 SOP 請見 → [電控組裝SOP.md](電控組裝SOP.md)

組裝順序摘要（**務必按順序執行**）：

1. 兩組 4S 電池盒分別量測電壓（14~16.8V）
2. XL4015 校準至 5.0V（**空載校準，三用電表確認**）
3. 兩顆 LM2596 分別校準至 5.0V
4. BTS7960 #1/#2/#3 接腿部 + FixedStage 電池，BTS7960 #4 接上半部電池，R_EN/L_EN 接 3.3V → 上電測試
5. LM2596-LegFixed → ESP32-C3 #1/#3；LM2596-Upper → ESP32-C3 #2 → 上電確認
6. C3 #1 → BTS7960 #1/#2 信號線 + 馬達 → Serial 測試
7. C3 #2 RotatingArm → Servo ×3 + BTS7960 #4 z 馬達 → Serial 測試
8. C3 #3 FixedStage → BTS7960 #3 spin 馬達 + Gate servo → Serial 測試
9. ESP32 主控 → ESP-NOW 三路通訊測試
10. BLE 藍芽連線測試

> ⚠ 每一步完成後都要**驗證**再進入下一步。切勿跳步驟！

## 共地匯流排設計

> 每組電源內的 GND 必須可靠連通。建議使用端子台集中管理。上半部 4S 與腿部 + FixedStage 4S 透過 ESP-NOW 無線通訊，正式架構下兩組 GND 不需要跨組連接。

```
腿部 + FixedStage GND 匯流排
  ├── 腿部 + FixedStage 電池 GND
  ├── BTS7960 #1 GND
  ├── BTS7960 #2 GND
  ├── BTS7960 #3 GND
  ├── XL4015-Gate GND
  ├── LM2596-LegFixed GND
  └── C3 #1/#3 GND

上半部 GND 匯流排
  ├── 上半部電池 GND
  ├── BTS7960 #4 GND
  ├── XL4015-UpperServo GND
  ├── LM2596-Upper GND
  └── C3 #2 GND

Servo GND 從各自的 XL4015 GND 端延伸，也必須與各自電池組 GND 匯流排連通。不要把上半部 XL4015-UpperServo GND 與腿部 + FixedStage XL4015-Gate GND 跨組相接。
```

> ⚠ 不要使用「菊花鏈」接法（A→B→C→D），改用「星形」接法（全部回到端子台），減少接觸電阻。

## 安全注意事項

1. 🔥 **禁止麵包板分電**：麵包板觸點僅額定 ~1A，不得用於 12V 電源分配（僅適合 3.3V/5V 信號原型）
2. 🔥 **禁止杜邦線作電源線**：杜邦線 28AWG 僅額定 1.4A，電源線必須使用 18-22AWG 矽膠線
3. **保險絲**：腿部 + FixedStage 電池正極出口必須串聯 15A 保險絲，上半部電池正極出口必須串聯 10A 保險絲，短路時保險絲熔斷保護線路
4. **端子台分電**：所有電源分配使用端子台，不得使用麵包板或任何臨時接法
5. **共地**：同一電池組內所有模組的 GND 都要連在一起；上半部組與腿部 + FixedStage 組不跨組共地
6. **ESP32 主控不需共地**：主控插電腦，透過 ESP-NOW 無線通訊，與機器人電源獨立
7. **勿反接**：馬達方向不對是正常的，改 BTS7960 M+/M- 接線即可，但電源 B+/B- 絕對不能反接
8. **先測後裝**：先在桌上測試所有接線，確認正常後再裝上底盤
9. **電池保護**：鋰電池不要過放（單顆低於 3.0V 就該充電），不用時拔掉電池接頭
10. **散熱**：BTS7960 效率高（>95%），幾乎不發熱
11. **ESP32-C3 電壓**：ESP32-C3 GPIO 為 3.3V 電平，BTS7960 原生支援 3.3V 邏輯；Servo 信號線可直接接（MG996R 接受 3.3V 信號）
12. **Servo 供電分離**：Servo 電源必須從 XL4015 取，不可從 LM2596 或 C3 取電，避免突波影響 MCU
13. **XL4015 校準**：首次使用 XL4015 時，先不接負載，通電後用三用電表量輸出，轉旋鈕調到 5.0V
14. **齒條超時保護**：r 齒條使用軟體超時保護（預設 5 秒），360° Servo 沒有位置回饋，超時後自動停止
15. **線材載流量**：電源線必須使用足夠粗的線材，杜邦線僅適用信號線（詳見 [電源預算.md](電源預算.md)）
16. **BTS7960 電源端子**：所有 B+ / B- 端子需鎖緊，鬆動會造成接觸不良或打火
