e14121040-netizen/2026-NCKU-ME-PROJECT/取物機器人(八足Jansen)/電控/電源預算.md

# 取物機器人 — 電源預算與線材規格

> 本文件詳細計算整台機器人的電流需求，並據此選擇線材規格與確認電池續航。  
> ⚠ **最後更新：2026/06/10** — 電池分配改為上半部 4S 與腿部 + FixedStage 4S 兩組。

---

## 系統電源架構總覽

```
腿部 + FixedStage 4S 18650（14.8V 標稱，16.8V 滿電）
    │
    ├──【15A 保險絲】── 腿部 + FixedStage 正極端子台
    │                     ├── BTS7960 #1/#2（JGB37-555 腿部馬達 ×2，18AWG）
    │                     ├── BTS7960 #3（FixedStage spin，18AWG）
    │                     ├── XL4015-Gate（5V/5A Gate servo 專用，20AWG）
    │                     └── LM2596-LegFixed（5V/3A MCU 專用，22AWG）── ESP32-C3 #1/#3
    │
    └── 腿部 + FixedStage GND 端子台（C3 #1/#3、BTS7960 #1/#2/#3、XL4015-Gate、LM2596-LegFixed 共地）

上半部 4S 18650（14.8V 標稱，16.8V 滿電）
    │
    ├──【10A 保險絲】── 上半部正極端子台
    │                     ├── BTS7960 #4（z 升降，18AWG）
    │                     ├── XL4015-UpperServo（5V/5A 上方 Servo ×3 專用，20AWG）
    │                     └── LM2596-Upper（5V/3A MCU 專用，22AWG）── ESP32-C3 #2
    │
    └── 上半部 GND 端子台（C3 #2、BTS7960 #4、XL4015-UpperServo、LM2596-Upper、上方 Servo ×3 共地）
```

> 正式架構中，上半部 4S 與腿部 + FixedStage 4S 只透過 ESP-NOW 無線通訊，兩組電源的正極不可相接，GND 也不需要跨組共地。Gate servo 屬於 FixedStage，必須接在腿部 + FixedStage 這組的 XL4015-Gate，不要接到上半部 XL4015-UpperServo。

---

## 1. 12V 側電流預算（電池直供 BTS7960）

| 馬達 | 型號 | 驅動板 | 空載 | 正常負載 | 堵轉 | 數量 | 正常合計 |
|---|---|---|---|---|---|---|---|
| 腿部步行 | JGB37-555 66rpm | **BTS7960 ×2** | ~0.4A | ~1.5~2.0A | ~6~8A | 2 | ~3.0~4.0A |
| FixedStage spin | XD-25GA 370 | **BTS7960 #3** | ~0.1A | ~0.5A | ~2A | 1 | ~0.5A |
| z 升降 | JGY370 蝸桿 | **BTS7960 #4** | ~0.1A | ~0.5A | ~3A | 1 | ~0.5A |

**腿部 + FixedStage 4S 電池組 DC 馬達側**：正常操作 ~4.0~5.5A，極端堵轉 ~14~18A（應避免）
**上半部 4S 電池組 DC 馬達側**：正常操作 ~0.5A，極端堵轉 ~1.5~3A（應避免）

### 壓降比較

| 驅動板 | 壓降 | 用途 |
|---|---|---|
| **BTS7960**（MOSFET） | **< 0.2V**（幾乎無） | 所有 DC 馬達（腿部、大圓盤、z 升降） |

**所有馬達實際電壓**（BTS7960，壓降 < 0.2V）：
- 16.8V 滿電 → 馬達約 16.6V：⚠ 高於 12V 馬達額定，不建議滿 duty 長時間運轉
- 14.8V 標稱 → 馬達約 14.6V：⚠ 仍高於 12V，需限制 PWM 並量測溫度/電流
- 12.0V 低電壓 → 馬達約 11.8V：✅ 接近 12V 額定

> ⚠ BTS7960 壓降低是優點，但不會幫 12V 馬達降壓。腿部 JGB37-555 改由 4S 鋰電池直供 BTS7960 時，韌體預設 duty 已降為 150；實測仍應先從 120~150 測試，並用三用電表/鉤表監控電流。若馬達溫度快速上升，應改用 3S 電池或高電流 12V 降壓供電。

---

## 2. 5V Servo 側（XL4015 5A ×2）

### MG996R 電流

| 場景 | 電流 | XL4015 足夠？ |
|---|---|---|
| 上方 Servo ×3 待機（XL4015-UpperServo） | ~0.3A | ✅ |
| 上方 1 顆動作 + 2 顆待機 | ~1.1A | ✅ |
| 上方 2 顆同時動作 | ~1.9A | ✅ |
| 上方 3 顆同時動作 | ~2.7A | ✅ |
| 上方 2 顆堵轉 + 1 顆動作 | ~6.0A | ❌ 超載 |
| Gate servo 單顆動作（XL4015-Gate） | ~0.5~1.0A | ✅ |
| Gate servo 堵轉 | ~2.5A | ✅，但不可長時間堵轉 |

> ⚠ 避免多顆 Servo 同時堵轉。操作流程應依序：r 伸出 → θ 旋轉 → 夾爪閉合。Gate servo 在腿部 + FixedStage 電池組，不能跟上半部 Servo 共用同一顆 XL4015。

### 電容緩衝

每顆 XL4015 輸出端並聯 1000μF 電解電容 + 100nF 陶瓷電容，吸收 Servo 啟動突波。

### XL4015 改用獨立 Servo 電池的可行性

| 方案 | 判斷 | 原因 |
|---|---|---|
| 2 顆 AA/AAA NiMH 充電電池（約 2.4~2.8V） | ❌ 不可行 | 電壓低於 XL4015 輸入範圍，也無法降壓出 5V |
| 2S 18650 鋰電池（串聯，滿電 8.4V、標稱 7.4V） | ⚠ 不建議直接接 XL4015 | XL4015 常見規格輸入操作範圍為 8~36V；2S 18650 放電後會低於 8V，Servo 負載突波時容易掉壓 |
| 3S 18650 或沿用主 4S 電池 → XL4015 | ✅ 可行 | 輸入電壓有足夠餘裕，但必須加 BMS、保險絲與共地 |
| 2S 18650 → 5V 5A buck-boost / UBEC | ✅ 可行 | 若一定要用 2 顆鋰電池，應改用支援 6~8.4V 輸入且連續輸出 ≥5A 的模組 |

> 若 Servo 電池獨立，Servo GND、該組 XL4015 OUT-、對應 C3 GND 仍必須在同一電池組內共地；ESP32 主控板因 ESP-NOW 無線通訊可維持 USB 獨立供電。

---

## 3. 5V MCU 側（LM2596 3A ×2）

| 場景 | 電流 | LM2596 足夠？ |
|---|---|---|
| C3 #1/#3 正常 (腿部 + FixedStage LM2596-LegFixed) | ~0.2A | ✅ 非常充裕 |
| C3 #2 正常 (上半部 LM2596-Upper) | ~0.1A | ✅ 非常充裕 |
| 3 板同時 TX | ~1.0A | ✅，但已分散到兩組 LM2596 |

---

## 4. 電池續航估算

**電池**：兩組 4S 18650，各組容量 ~2600mAh（可用 80% ≈ 2080mAh）

| 電池組 | 場景 | 總電流 | 預估續航 |
|---|---|---|---|
| 腿部 + FixedStage 4S | 正常步行 + 偶爾 FixedStage | ~4.0~5.5A | ~23~31 分鐘 |
| 腿部 + FixedStage 4S | 密集步行 / 卡滯偏高 | ~6.0A | ~21 分鐘 |
| 上半部 4S | 手臂交替 + z + C3 #2 | ~1.5~2.5A | ~50~83 分鐘 |
| 上半部 4S | 頻繁夾取 + z | ~3.0A | ~41 分鐘 |

> 比賽每輪 8 分鐘，腿部 + FixedStage 電池會是主要續航限制。建議每 2 輪更換或至少量測腿部 + FixedStage 4S 電池電壓。

---

## 5. 線材規格建議

### AWG 載流量

| AWG | 直徑 | 安全電流 | 適用 |
|-----|---|---|---|
| 16 | 1.29mm | 15A | 腿部 + FixedStage 電池 → 15A 保險絲 → 端子台主幹 |
| 18 | 1.02mm | 10A | 端子台 → BTS7960 分支電源 |
| 20 | 0.81mm | 7A | BTS7960 → 馬達 |
| 22 | 0.64mm | 5A | XL4015 → Servo 電源 |
| 24 | 0.51mm | 3.5A | LM2596 → MCU |
| 28 (杜邦線) | 0.32mm | 1.4A | 信號線 |

### 各段接線規格

| 接線段 | AWG | 最大電流 | 端子 |
|---|-----|---|---|
| 腿部 + FixedStage 電池 → 15A 保險絲 → 端子台 | 16 | 腿部 + FixedStage 合計峰值 | 端子台螺絲 |
| 腿部 + FixedStage 端子台 → BTS7960 #1/#2 B+ | 18 | ~8A 單路峰值 | 端子台螺絲 |
| 腿部 + FixedStage 端子台 → BTS7960 #3 B+ | 18 | ~2A 峰值 | 端子台螺絲 |
| 上半部電池 → BTS7960 #4 B+ | 18 | ~3A 峰值 | 端子台螺絲 |
| 電池 → XL4015 IN | 20 | ~3A | 焊接/端子台 |
| 電池 → LM2596 IN | 22 | ~0.5A | 焊接/端子台 |
| XL4015 OUT → Servo V+ | 22 | ~5A 峰值 | 焊接+杜邦母頭 |
| LM2596 OUT → C3 5V | 24 | ~0.3A | 杜邦線 |
| BTS7960 M+/M- → 腿部 JGB37-555 | 20 | ~8A 峰值 | 端子台螺絲 |
| BTS7960 M+/M- → FixedStage / z DC 馬達 | 20 | ~3A 峰值 | 端子台螺絲 |
| C3 GPIO → BTS7960 RPWM/LPWM | 杜邦(28) | <100mA | 杜邦公母 |
| C3 GPIO → Servo 信號 | 杜邦(28) | <10mA | 杜邦公母 |
| 腿部 + FixedStage 電池 → GND 匯流主幹 | 16 | 腿部 + FixedStage 合計電流 | 端子台 |
| 腿部 + FixedStage GND 匯流 → BTS7960 #1/#2/#3 | 18 | ~8A 單路峰值 | 端子台 |
| 上半部 GND 匯流 | 18 | 上半部合計電流 | 端子台 |

> ⚠ **杜邦線不可用於電源線！** 僅適用於信號線和 MCU 供電（<1A）。
>
> 🔥 **嚴禁事項**：
> - ❌ 不得使用麵包板 (breadboard) 分配 12V 電源（觸點僅額定 ~1A）
> - ❌ 不得使用杜邦線 (28AWG) 作為電池到馬達驅動的電源線
> - ✅ 電源分配必須使用**端子台 (terminal block)** + 對應 AWG 矽膠線
> - ✅ 腿部 + FixedStage 電池正極必須串聯 **15A 保險絲**；上半部電池正極串聯 **10A 保險絲**

---

## 6. 安全閾值彙整

| 參數 | 安全範圍 | 警告 | 危險 |
|---|---|---|---|
| 單組 4S 電池組電壓 | 14.0~16.8V | <13.0V | <12.0V |
| XL4015 輸出 | 4.9~5.1V | <4.7V | <4.5V |
| LM2596 輸出 | 4.9~5.1V | <4.7V | <4.5V |
| BTS7960 溫度 | <40°C | 40-60°C | >70°C |
| 單顆 18650 | 3.5~4.2V | <3.2V | <3.0V |
| 保險絲 | 未熔斷 | — | 熔斷（排查短路） |
