e14121040-netizen/2026-NCKU-ME-PROJECT/取物機器人(八足Jansen)/電控/馬達扭矩分析報告.md

# 取物機器人 — 馬達扭矩分析報告

> 本報告整理取物機器人（八足 Theo Jansen）所使用的全部馬達之扭矩規格與應用分析。  
> ⚠ **日期：2026/06/02** — 腿部馬達更新為 JGB37-555 DC 12V 66rpm。

---

## 系統馬達總覽

本機器人共使用 **4 種馬達、共 8 顆**，分為 DC 減速馬達（4 顆）和伺服馬達（4 顆）兩大類。

| # | 馬達型號 | 類型 | 數量 | 用途 | 控制板 |
|---|---|---|---|---|---|
| 1 | JGB37-555 66rpm | DC 減速馬達 | 2 | 腿部步行（原地旋轉轉向） | C3 #1 |
| 2 | XD-25GA 370 | DC 減速馬達（自鎖） | 1 | 夾爪底部大圓盤旋轉 | C3 #2 |
| 3 | JGY370 | DC 蝸桿減速馬達（自鎖） | 1 | z 方向升降 | C3 #2 |
| 4 | MG996R（360°） | 連續旋轉伺服馬達 | 1 | r 齒條伸縮 | C3 #3 |
| 5 | MG996R（180°） | 標準伺服馬達 | 3 | θ 旋轉 + 夾爪開合 + 承物盒擋板 | C3 #3 |

---

## 一、JGB37-555 直流減速馬達 ×2（腿部步行）

### 規格參數

| 參數 | 數值 |
|---|---|
| **工作電壓** | 12V DC |
| **空載轉速** | ~66 RPM |
| **減速比** | 依供應商齒輪箱規格確認 |
| **額定扭矩** | **2.0 ~ 3.0 kg·cm**（保守估算，需實測確認） |
| **堵轉扭矩** | **6.0 ~ 9.0 kg·cm**（保守估算，需實測確認） |
| **空載電流** | ~0.4A |
| **額定電流** | ~1.5 ~ 2.0A |
| **堵轉電流** | ~6 ~ 8A |
| **驅動方式** | BTS7960 ×2（MOSFET H-Bridge，43A 額定） |

### 扭矩單位換算

| 表示法 | 額定扭矩 | 堵轉扭矩 |
|---|---|---|
| kg·cm | 2.0 ~ 3.0 | 6.0 ~ 9.0 |
| N·cm | 19.6 ~ 29.4 | 58.8 ~ 88.2 |
| N·m | 0.196 ~ 0.294 | 0.588 ~ 0.882 |
| oz·in | 27.8 ~ 41.7 | 83.4 ~ 125.1 |

### 應用分析

```
用途：左右各 1 顆馬達驅動八足 Theo Jansen 連桿步行
      原地旋轉轉向（前後同速，左右反向）

負載估算：
  - 機器人總重量（預估）：~2~3 kg（含電池、機構、夾爪）
  - 八足均分負載：每側 4 足 ≈ 承擔 ~1~1.5 kg
  - 以 0.7 縮放因子的 Theo Jansen 連桿計算
  - 曲柄半徑 r ≈ 15mm = 1.5cm（估算）
  - 所需扭矩 T = F × r = 1.5 kg × 1.5 cm = 2.25 kg·cm

安全裕度：
  - 額定扭矩 2.0~3.0 kg·cm → ✅ 較原 520 馬達方案有更高裕度
  - 堵轉扭矩 6.0~9.0 kg·cm → ✅ 有餘裕，但不應長時間堵轉
  - 建議：實測時監控電流，若單顆常態超過 2A 表示負載偏高
```

> ⚠ **注意**：JGB37-555 是系列型號，不同供應商的齒輪箱精確規格可能有差異。本節數值以 66rpm 版本保守估算，最終仍要以供應商 datasheet 與實測電流確認。

---

## 二、XD-25GA 370 直流減速馬達 ×1（大圓盤旋轉）

### 規格參數

| 參數 | 數值 |
|---|---|
| **工作電壓** | 12V DC |
| **空載轉速** | ~50 RPM |
| **額定扭矩** | **~5 ~ 8 kg·cm**（50RPM 版本估算） |
| **堵轉扭矩** | **~18 ~ 24 kg·cm** |
| **空載電流** | ~0.1A |
| **額定電流** | ~0.5A |
| **堵轉電流** | ~2A |
| **自鎖功能** | ✅ 斷電後軸不可自由旋轉（高減速比摩擦自鎖） |
| **驅動方式** | BTS7960 #3（MOSFET H-Bridge） |

### 扭矩單位換算

| 表示法 | 額定扭矩（估） | 堵轉扭矩 |
|---|---|---|
| kg·cm | 5 ~ 8 | 18 ~ 24 |
| N·cm | 49 ~ 78 | 176 ~ 235 |
| N·m | 0.49 ~ 0.78 | 1.76 ~ 2.35 |

### 應用分析

```
用途：夾爪底部大圓盤旋轉（提供整體旋轉自由度）

負載估算：
  - 夾爪機構重量（預估）：~300 ~ 500g
  - 大圓盤半徑 R ≈ 5 ~ 8cm
  - 旋轉摩擦力矩：取決於軸承品質
  - 所需扭矩（預估）：~1 ~ 3 kg·cm

安全裕度：
  - 額定扭矩 5~8 kg·cm → ✅ 非常充裕
  - 自鎖功能 → ✅ 斷電後不會自由旋轉，維持位置
  - 結論：此馬達扭矩對大圓盤應用而言非常充足
```

---

## 三、JGY370 蝸桿減速馬達 ×1（z 方向升降）

### 規格參數

| 參數 | 數值 |
|---|---|
| **工作電壓** | 12V DC |
| **減速機構** | 蝸桿齒輪（Worm Gear） |
| **空載轉速** | 依減速比而定（通常 2 ~ 210 RPM） |
| **額定扭矩** | **1.2 ~ 25 kg·cm**（依減速比） |
| **堵轉扭矩** | **2.2 ~ 30 kg·cm**（依減速比） |
| **堵轉電流** | ~1A |
| **自鎖功能** | ✅ 蝸桿機構天生自鎖，斷電不會下滑 |
| **驅動方式** | BTS7960 #4（MOSFET H-Bridge） |

> ⚠ JGY370 是系列型號，扭矩高度依賴減速比。低 RPM 版本（如 2~10 RPM）扭矩可達 25+ kg·cm；高 RPM 版本（如 100~200 RPM）扭矩較低。

### 假設使用低 RPM 版本（~10~30 RPM，適合升降）

| 表示法 | 額定扭矩（估） | 堵轉扭矩（估） |
|---|---|---|
| kg·cm | 10 ~ 20 | 15 ~ 30 |
| N·cm | 98 ~ 196 | 147 ~ 294 |
| N·m | 0.98 ~ 1.96 | 1.47 ~ 2.94 |

### 應用分析

```
用途：z 方向升降（垂直提升夾爪機構）

負載估算：
  - 需提升的載重：夾爪 + 手臂 + 夾取物品 ≈ 500g ~ 1kg
  - 升降機構的導螺桿導程或齒輪半徑：取決於機構設計
  - 假設升降螺桿導程 = 8mm/rev → 提升 1kg 所需扭矩：
    T = (m × g × lead) / (2π × η)
    T = (1 × 9.8 × 0.008) / (2π × 0.3)  ← η=0.3（蝸桿效率）
    T ≈ 0.042 N·m ≈ 0.42 kg·cm

安全裕度：
  - 即使是低減速比版本，額定扭矩 > 10 kg·cm
  - 所需扭矩 < 1 kg·cm → ✅ 極為充裕
  - 蝸桿自鎖 → ✅ 斷電不會下滑，安全性極佳
  - 結論：z 升降的扭矩完全足夠，自鎖特性是關鍵優勢
```

---

## 四、MG996R 伺服馬達（360° 連續旋轉）×1（r 齒條伸縮）

### 規格參數

| 參數 | 數值（@5V 供電） |
|---|---|
| **工作電壓** | 4.8V ~ 6.6V |
| **堵轉扭矩 @4.8V** | **9.4 kg·cm** |
| **堵轉扭矩 @6.0V** | **11 kg·cm** |
| **實際供電** | 5V（XL4015 降壓模組） |
| **堵轉扭矩 @5V（內插）** | **~10 kg·cm** |
| **空載轉速** | ~55 RPM（連續旋轉模式） |
| **堵轉電流** | ~2.5A @6V |
| **齒輪材質** | 金屬齒輪 |
| **重量** | ~55g |
| **位置回饋** | ❌ 無（連續旋轉版無法定位） |

### 扭矩單位換算（@5V 估算）

| 表示法 | 堵轉扭矩 |
|---|---|
| kg·cm | ~10 |
| N·cm | ~98 |
| N·m | ~0.98 |
| oz·in | ~139 |

### 應用分析

```
用途：驅動齒條做線性伸縮（r 方向）

負載估算：
  - 齒條重量 + 夾爪重量：~200 ~ 400g
  - 齒輪節圓半徑 r ≈ 1 ~ 1.5cm（雷切壓克力齒輪）
  - 齒條移動所需扭矩 T = F_friction × r
  - 假設摩擦力 ≈ 2N（滑軌 MGN12 摩擦很小）
  - T = 2 × 1.5 = 3 N·cm = 0.3 kg·cm

安全裕度：
  - 堵轉扭矩 ~10 kg·cm vs 所需 ~0.3 kg·cm
  - ✅ 安全裕度極大（>30 倍）
  - ⚠ 但 360° Servo 無位置回饋，需超時保護防止過行程
```

---

## 五、MG996R 伺服馬達（180° 標準）×3（θ 旋轉 + 夾爪開合 + 承物盒擋板）

### 規格參數

| 參數 | 數值（@5V 供電） |
|---|---|
| **工作電壓** | 4.8V ~ 6.6V |
| **堵轉扭矩 @4.8V** | **9.4 kg·cm** |
| **堵轉扭矩 @6.0V** | **11 kg·cm** |
| **實際供電** | 5V（XL4015 降壓模組） |
| **堵轉扭矩 @5V（內插）** | **~10 kg·cm** |
| **工作角度** | 0° ~ 180° |
| **死帶寬** | ~5μs |
| **堵轉電流** | ~2.5A @6V |
| **齒輪材質** | 金屬齒輪 |
| **重量** | ~55g |
| **位置回饋** | ✅ 有（內建電位器回饋） |

### 應用分析（逐一）

#### 5a. θ 旋轉（夾爪角度旋轉）

```
用途：控制夾爪的角度旋轉

負載估算：
  - 夾爪末端重量：~100 ~ 200g
  - 旋轉臂長：~3 ~ 5cm
  - 所需扭矩 T = m × g × L = 0.2 × 9.8 × 5 = 9.8 N·cm ≈ 1.0 kg·cm

安全裕度：
  - 堵轉扭矩 ~10 kg·cm vs 所需 ~1.0 kg·cm → ✅ 充裕（10 倍）
  - 180° 定位精確 → ✅ 適合角度控制
```

#### 5b. 夾爪開合

```
用途：控制夾爪板的張開與閉合

負載估算：
  - 夾取物最重：線性襯套 83.3g
  - 夾持力需克服物品重力 + 提供摩擦力
  - 假設需要 5N 夾持力、齒條半徑 r ≈ 1cm
  - 所需扭矩 T = 5 × 1 = 5 N·cm ≈ 0.5 kg·cm

安全裕度：
  - 堵轉扭矩 ~10 kg·cm vs 所需 ~0.5 kg·cm → ✅ 非常充裕（20 倍）
  - 含止滑墊增加摩擦力 → 可降低所需夾持力
```

#### 5c. 承物盒擋板（旋轉門式）

```
用途：承物盒的旋轉門式擋板開合

負載估算：
  - 擋板重量：~50 ~ 100g（壓克力板）
  - 旋轉軸到重心距離：~3cm
  - 所需扭矩 T = m × g × L = 0.1 × 9.8 × 3 = 2.94 N·cm ≈ 0.3 kg·cm
  - 擋板承受物品側壓力時（最差情況）：
    假設 200g 物品壓在擋板上，力臂 3cm
    T = 0.2 × 9.8 × 3 = 5.88 N·cm ≈ 0.6 kg·cm

安全裕度：
  - 堵轉扭矩 ~10 kg·cm vs 所需 ~0.6 kg·cm → ✅ 非常充裕（>16 倍）
  - 180° 定位精確 → ✅ 適合開/關兩段位置
```

---

## 扭矩總覽對照表

| 馬達 | 用途 | 額定/堵轉扭矩 | 預估所需扭矩 | 安全裕度 | 自鎖 |
|---|---|---|---|---|---|
| JGB37-555 ×2 | 腿部步行 | 2.0~3.0 / 6.0~9.0 kg·cm | ~2.25 kg·cm | ✅ **1.8~2.7x** | ❌ |
| XD-25GA 370 ×1 | 大圓盤旋轉 | 5~8 / 18~24 kg·cm | ~1~3 kg·cm | ✅ **5~8x** | ✅ |
| JGY370 ×1 | z 升降 | 10~20 / 15~30 kg·cm | ~0.42 kg·cm | ✅ **>24x** | ✅ 蝸桿 |
| MG996R 360° ×1 | r 齒條伸縮 | — / ~10 kg·cm | ~0.3 kg·cm | ✅ **>30x** | ❌ |
| MG996R 180° (θ) ×1 | 夾爪旋轉 | — / ~10 kg·cm | ~1.0 kg·cm | ✅ **10x** | ✅ PWM |
| MG996R 180° (夾爪) ×1 | 夾爪開合 | — / ~10 kg·cm | ~0.5 kg·cm | ✅ **20x** | ✅ PWM |
| MG996R 180° (擋板) ×1 | 承物盒擋板 | — / ~10 kg·cm | ~0.6 kg·cm | ✅ **>16x** | ✅ PWM |

> **安全裕度建議**：工程實務中建議安全裕度 ≥ 2x。大於 3x 為理想值。

---

## 承載能力分析（反推最大載重）

> 以下根據各馬達的扭矩規格，**反推**每個機構能夠承受的最大載重。
> 結合比賽零件重量，評估實際操作能力。

### 比賽目標物重量一覽

| 零件 | 單重 | 6 個總重 | 累計（由重到輕） |
|---|---|---|---|
| 線性襯套 | 83.3g | 499.8g | 499.8g |
| 大螺帽 | 69.1g | 414.6g | 914.4g |
| 六角螺栓 | 56.2g | 337.2g | 1,251.6g |
| 蝶形螺帽 | 30.2g | 181.2g | 1,432.8g |
| 滾珠軸承 | 28.2g | 169.2g | 1,602.0g |
| 壓縮彈簧 | 17.5g | 105.0g | 1,707.0g |
| 小螺帽 | 15.6g | 93.6g | 1,800.6g |
| 拉伸彈簧 | 9.2g | 55.2g | 1,855.8g |
| **全部 48 個** | — | — | **1,855.8g ≈ 1.86 kg** |

---

### 1. 腿部步行馬達（JGB37-555 ×2）— 整機最大承載

```
反推公式：
  T_avail = T_rated × 2（左右兩顆馬達合計）
  F_max = T_avail / r_crank

參數：
  T_rated（單顆） = 2.0 ~ 3.0 kg·cm
  T_rated（雙顆合計） = 4.0 ~ 6.0 kg·cm
  T_stall（雙顆合計） = 12.0 ~ 18.0 kg·cm
  曲柄半徑 r ≈ 1.5cm

最大可驅動負重（額定扭矩，持續運轉安全值）：
  m_rated = T_rated_total / r = 4.0~6.0 / 1.5 = 2.7~4.0 kg

最大可驅動負重（堵轉扭矩，瞬間極限值）：
  m_stall = T_stall_total / r = 12.0~18.0 / 1.5 = 8.0~12.0 kg
```

| 指標 | 數值 |
|---|---|
| **持續安全承載** | **約 2.7~4.0 kg**（含機器人自重，需實測確認） |
| **瞬間極限承載** | **約 8.0~12.0 kg**（含機器人自重，不可持續） |
| 機器人空載重量（預估） | ~2.0 ~ 2.5 kg |
| **可額外搭載零件** | **約 0.2 ~ 1.5 kg（額定估算）** |

```
比賽應用評估：
  - 機器人自重 ≈ 2.0 ~ 2.5 kg
  - 可額外承載零件 ≈ 200g ~ 1.5kg（持續安全運轉，需實測）
  - 以最重零件「線性襯套 83.3g」計算 → 最多約 6 個
  - 以平均零件重量 ~38.7g 計算 → 最多約 12 個
  - 一次搬運 6~12 個零件 → ✅ 一次處理 1~2 筆訂單

  ⚠ 如果機器人自重超過 3.0 kg：
     → 額定裕度下降，步行時需降低 PWM 並監控電流
     → 馬達電流升高，溫度上升，建議限制連續步行時間
```

> ⚠ **腿部仍是整個系統的主要風險點**。JGB37-555 66rpm 比原方案有更高扭矩，但 4S 直供 12V 馬達時必須實測電流與溫度。

---

### 2. 大圓盤旋轉馬達（XD-25GA 370）— 旋轉承載

```
反推公式：
  大圓盤旋轉不直接承受垂直載重（由軸承支撐）
  旋轉所需扭矩主要來自摩擦力矩和偏心力矩

  T_friction = μ × m × g × R_bearing
  T_eccentric = m_load × g × d_offset

參數：
  T_rated = 5 ~ 8 kg·cm
  軸承摩擦係數 μ ≈ 0.01（推力軸承）~ 0.3（無軸承滑動）
  軸承半徑 R ≈ 2cm

最大可旋轉載重（假設 μ=0.1，R=2cm）：
  m_max = T_rated / (μ × g × R)
        = 5 / (0.1 × 0.98 × 2)
        = 5 / 0.196
        ≈ 25.5 kg
```

| 指標 | 數值 |
|---|---|
| **最大旋轉承載** | **≫ 5 kg**（遠超需求） |
| 實際旋轉載重 | 夾爪 + 物品 ≈ 300 ~ 500g |
| 安全裕度 | ✅ **>10x** |

> ✅ 大圓盤的旋轉承載不是瓶頸。

---

### 3. z 升降馬達（JGY370 蝸桿）— 垂直提升承載

```
反推公式（螺桿傳動）：
  m_max = (T_rated × 2π × η) / (g × lead)

參數：
  T_rated = 10 ~ 20 kg·cm = 0.98 ~ 1.96 N·m
  η = 0.3（蝸桿效率保守值）
  lead = 8mm/rev = 0.008 m/rev
  g = 9.8 m/s²

最大提升載重：
  m_max = (0.98 × 2π × 0.3) / (9.8 × 0.008)
        = (0.98 × 1.885) / 0.0784
        = 1.847 / 0.0784
        ≈ 23.6 kg

  （取高扭矩端）
  m_max_high = (1.96 × 1.885) / 0.0784 ≈ 47.1 kg
```

| 指標 | 數值 |
|---|---|
| **最大垂直提升** | **23.6 ~ 47.1 kg**（理論值） |
| 實際提升載重 | 夾爪 + 手臂 + 物品 ≈ 500g ~ 1 kg |
| 安全裕度 | ✅ **>23x** |

> ✅ z 升降的承載能力極為充裕，完全不是瓶頸。蝸桿自鎖確保斷電不下滑。

---

### 4. r 齒條伸縮（MG996R 360°）— 水平推送承載

```
反推公式：
  齒條為水平移動，主要克服摩擦力
  F_max = T_stall / r_gear

參數：
  T_stall = ~10 kg·cm = 98 N·cm
  齒輪節圓半徑 r ≈ 1.5cm

最大推送力：
  F_max = 98 / 1.5 ≈ 65 N ≈ 6.6 kg

可承載重量（假設滑軌摩擦係數 μ=0.1）：
  m_max = F_max / (μ × g)
        = 65 / (0.1 × 9.8)
        ≈ 66 kg（水平推送時）

可懸吊重量（齒條垂直向下伸出時的最差情況）：
  m_max_vertical = T_stall / (g × r)
                 = 98 / (9.8 × 1.5)
                 ≈ 6.7 kg
```

| 指標 | 數值 |
|---|---|
| **最大水平推送力** | **~65 N（≈ 6.6 kgf）** |
| **最大垂直懸吊** | **~6.7 kg** |
| 實際載重 | 夾爪末端 + 物品 ≈ 200 ~ 400g |
| 安全裕度 | ✅ **>16x** |

> ✅ r 齒條承載不是瓶頸。

---

### 5. 夾爪 θ 旋轉（MG996R 180°）— 手臂末端承載

```
反推公式：
  m_max = T_stall / (g × L_arm)

參數：
  T_stall = ~10 kg·cm = 98 N·cm
  手臂長度 L ≈ 5cm（從旋轉軸到夾爪末端）

最大末端承載：
  m_max = 98 / (9.8 × 5) = 98 / 49 = 2.0 kg

  （若臂長 L = 3cm）：
  m_max = 98 / (9.8 × 3) = 98 / 29.4 = 3.3 kg
```

| 指標 | 數值 |
|---|---|
| **最大末端承載（L=5cm）** | **~2.0 kg** |
| **最大末端承載（L=3cm）** | **~3.3 kg** |
| 最重零件（線性襯套） | 83.3g |
| 安全裕度（單件） | ✅ **>24x** |

> ✅ 夾爪旋轉可輕鬆承載任何比賽零件。

---

### 6. 夾爪開合（MG996R 180°）— 夾持力

```
反推公式：
  F_grip = T_stall / r_mechanism

參數：
  T_stall = ~10 kg·cm = 98 N·cm
  夾爪齒條半徑 r ≈ 1cm

最大夾持力：
  F_grip = 98 / 1 = 98 N ≈ 10 kgf

可夾持的最大重量（靠摩擦力支撐，μ=0.5 止滑墊）：
  m_max = F_grip × μ / g
        = 98 × 0.5 / 9.8
        = 5.0 kg
```

| 指標 | 數值 |
|---|---|
| **最大夾持力** | **~98 N（≈ 10 kgf）** |
| **靠摩擦可夾住** | **~5.0 kg**（含止滑墊） |
| 最重零件（線性襯套） | 83.3g |
| 安全裕度（單件） | ✅ **>60x** |

> ✅ 夾爪的夾持力完全不是問題。

---

### 7. 承物盒擋板（MG996R 180°）— 擋板承壓能力

```
反推公式：
  擋板為旋轉門式，物品側向壓在擋板上
  m_max = T_stall / (g × L_gate)

參數：
  T_stall = ~10 kg·cm = 98 N·cm
  擋板力臂（旋轉軸到壓力點）L ≈ 3cm

最大擋板承壓：
  m_max = 98 / (9.8 × 3) = 98 / 29.4 ≈ 3.3 kg
```

| 指標 | 數值 |
|---|---|
| **最大擋板承壓** | **~3.3 kg** |
| 承物盒預計裝載 | ~6~12 個零件 ≈ 200 ~ 500g |
| 安全裕度 | ✅ **>6x** |

> ✅ 擋板可承受承物盒中所有零件的側壓力。

---

### 📊 承載能力總覽

| 機構 | 馬達 | 最大承載 | 實際需求 | 裕度 | 瓶頸？ |
|---|---|---|---|---|---|
| 🦿 腿部步行 | JGB37-555 ×2 | 整機約 **2.7~4.0 kg** | 自重 2.0~2.5 kg | ⚠ **需實測** | 🟠 主要風險 |
| 🔄 大圓盤旋轉 | XD-25GA 370 | ≫ **5 kg** | ~0.5 kg | ✅ >10x | 否 |
| ⬆ z 升降 | JGY370 | **23.6 ~ 47 kg** | ~1 kg | ✅ >23x | 否 |
| ↔ r 齒條推送 | MG996R 360° | **6.7 kg**（垂直）| ~0.4 kg | ✅ >16x | 否 |
| 🔁 θ 旋轉 | MG996R 180° | **2.0 ~ 3.3 kg** | ~0.2 kg | ✅ >10x | 否 |
| 🤏 夾爪夾持 | MG996R 180° | **5.0 kg**（摩擦）| ~0.083 kg | ✅ >60x | 否 |
| 🚪 擋板承壓 | MG996R 180° | **3.3 kg** | ~0.5 kg | ✅ >6x | 否 |

### 📋 實際操作能力評估

```
場景 A：輕裝操作（推薦）
  - 一次搬運 6 個零件（約一筆訂單）
  - 預估載重：6 × 38.7g(平均) ≈ 232g
  - 整機重量：2.0 kg + 0.23 kg = 2.23 kg
  - 腿部安全裕度：4.0~6.0 / (2.23 × 1.5cm) = 1.2~1.8 → ✅ 可行，需實測電流

場景 B：中等負載
  - 一次搬運 12 個零件（約兩筆訂單）
  - 預估載重：12 × 38.7g ≈ 464g
  - 整機重量：2.0 kg + 0.46 kg = 2.46 kg
  - 結論：✅ 可行，建議減慢行走速度並監控腿部電流

場景 C：滿載操作（不建議）
  - 一次搬運 24 個零件
  - 預估載重：24 × 38.7g ≈ 929g
  - 整機重量：2.0 kg + 0.93 kg = 2.93 kg
  - 結論：⚠ 接近高負載區，需降低 PWM，仍不建議長時間行走

🏆 比賽策略建議：
  - 每次搬運 6~8 個零件（~250~310g）
  - 多趟搬運比單次滿載更安全
  - 8 分鐘比賽時間足夠 3~4 趟
  - 優先夾取較輕的零件（彈簧、小螺帽）減輕負擔
```

---

## 風險評估與建議

### 🟠 中高風險：腿部馬達（JGB37-555）

```
問題：腿部仍承擔整機重量與行走衝擊，JGB37-555 66rpm 的扭矩較高，
      但不同供應商規格差異大，必須用實測電流確認安全裕度。

風險：
  1. 長時間高 duty 運轉可能導致馬達過熱
  2. 上坡或不平路面時堵轉風險高
  3. 4S 滿電 16.8V 高於 12V 額定，需限制 PWM

建議：
  ✅ 減輕機器人重量（輕量化設計）
  ✅ 初測 PWM duty 先用 120~150，再逐步上調
  ✅ 監控馬達溫度和電流
  ✅ 限制持續運轉時間
  ✅ 八足連桿設計確保足部分擔負載均勻
```

### 🟢 低風險：夾爪系統（MG996R + XD-25GA 370 + JGY370）

```
所有夾爪相關馬達的安全裕度均 ≥ 5x，扭矩非常充裕。
蝸桿自鎖和 Servo PWM 保持功能確保斷電安全。
```

---

## 附錄：扭矩計算公式

### DC 馬達扭矩-轉速關係

```
T = T_stall × (1 - ω/ω_no_load)

其中：
  T_stall = 堵轉扭矩（ω = 0 時的最大扭矩）
  ω_no_load = 空載轉速（T = 0 時的最大轉速）
  T = 在轉速 ω 時的可用扭矩
```

### 升降所需扭矩（螺桿傳動）

```
T = (m × g × lead) / (2π × η)

其中：
  m = 載重質量 (kg)
  g = 重力加速度 (9.8 m/s²)
  lead = 螺桿導程 (m/rev)
  η = 傳動效率（蝸桿 ≈ 0.3~0.5）
```

### 齒條驅動所需扭矩

```
T = F × r

其中：
  F = 移動齒條所需的力 (N)
  r = 驅動齒輪節圓半徑 (m)
```

### 旋轉機構所需扭矩

```
T = m × g × L

其中：
  m = 旋轉物體質量 (kg)
  g = 重力加速度 (9.8 m/s²)
  L = 質心到旋轉軸的距離 (m)
```

---

## 參考資料

- JGB37-555 66rpm supplier datasheet / measured current logs（待實測補齊）
- 25GA-370 Motor Series — FluxElectronix, AliExpress
- JGY370 Worm Gear Motor — RobotShop, ElectronicsComp, DigiKey
- MG996R Servo Datasheet — Components101, HandsOnTec, AllDatasheet
- Theo Jansen 連桿力學 — 機構設計目錄參考文件

---

> ⚠ **免責聲明**：本報告中的馬達規格數據取自公開資料、供應商標稱與保守估算，由於 JGB37-555、XD-25GA 370、JGY370 系列馬達為通用型號，不同製造商的實際規格可能有所差異。建議以供應商提供的具體 Datasheet 為準，並透過實測電流驗證實際扭矩。
