e14121040-netizen/2026-NCKU-ME-PROJECT/文件/報告/專題計劃書.md

# 114 學年度第二學期

# 機械專題實作

# 專題計劃書

> **日期**：115 年 04 月 02 日

---

## 組員資料

| 班級 | 組別 | 組員學號 | 姓名 | 貢獻度 (%) |
|---|---|---|---|---|
| 機三乙 | 第 2 組 | E14126511 | 詹澄汯 | 15% |
| 機三乙 | 第 2 組 | E14121040 | 鍾沅駿 | 14% |
| 機三乙 | 第 2 組 | E14126529 | 吳昆哲 | 14% |
| 機三乙 | 第 2 組 | E14122216 | 李耿泓 | 14% |
| 機三乙 | 第 2 組 | E14139043 | 王子睿 | 14% |
| 機三乙 | 第 2 組 | E14102119 | 陳翊家 | 15% |
| 機三乙 | 第 2 組 | E14122208 | 陳昱辰 | 14% |

> ⚠ 貢獻度加總必須等於 **100%**。

---

## 目錄

一、[計畫目標](#一計畫目標)

二、[動機與文獻回顧](#二動機與文獻回顧)

三、[組員工作分配](#三組員工作分配)

四、[進度規劃](#四進度規劃)

五、[設計概念草圖](#五設計概念草圖)

六、[總預算規劃](#六總預算規劃)

七、[參考文獻](#七參考文獻)

---

## 一、計畫目標

本專題旨在設計並實作兩款功能互補、協同工作的機器人系統，模擬智慧倉儲物流場景中的「取物」與「運輸」作業。兩台機器人需在 **8 分鐘**的比賽時間內完成盡可能多次的零件搬運流程。

| 機器人 | 類型 | 操控方式 | 尺寸限制 | 核心功能 |
|---|---|---|---|---|
| **取物機器人** | 八足 Theo Jansen 連桿 | 手機藍芽遙控 | ≤ 400×400 mm | 從 S 形貨架夾取零件、暫存並轉移至運輸機器人 |
| **運輸機器人** | LEGO EV3 輪式 | 全自動循跡 | ≤ 400×300 mm | 沿黑線自動循跡行駛，將零件推落至放置區平台 |

### 競賽規則摘要

| 項目 | 規則 |
|---|---|
| 比賽時間 | 每回合 **8 分鐘** |
| 競賽制度 | 三輪競賽，取最高分計入成績 |
| 計分 | 零件放入放置區 = **1 分/個**（最高 48 分）+ 對戰分數 2 分 |
| 扣分 | 掉落零件 **-1 分/個**、機器人殘留零件 **-1 分/個** |
| 重置 | 每台有 1 次免費重置，第 2 次起每次 **-1 分** |
| 區域限制 | 取物機器人**不可進入運輸區** |
| 及格分數 | 3 分 = 百分比 70 分 |

### 目標物規格

比賽需搬運 8 種零件，每種 6 個，共 48 個：

| 零件 | 重量 | 關鍵尺寸 | 夾取難度 |
|---|---|---|---|
| 線性襯套 | 83.3g | 外徑 32mm | ★★★（最重、最大）|
| 大螺帽 | 69.1g | — | ★★ |
| 六角螺栓 | 56.2g | — | ★★ |
| 蝶形螺帽 | 30.2g | 有翼 | ★★★（形狀不規則）|
| 滾珠軸承 | 28.2g | 外徑 28mm | ★★ |
| 壓縮彈簧 | 17.5g | 外徑 27mm | ★★ |
| 小螺帽 | 15.6g | — | ★ |
| 拉伸彈簧 | 9.2g | 外徑 16mm | ★★ |

> **設計考量**：夾爪開口需 > 32mm（線性襯套外徑），夾持力需能穩固抓住 83.3g 零件；貨架高度為置物盤底部 156mm、邊框高 200mm，手臂需能伸入此範圍。

---

## 二、動機與文獻回顧

### 2.1 動機

現代倉儲物流系統朝自動化與智慧化發展，Amazon Kiva 機器人、自動導引車 (AGV) 等技術已廣泛應用於實際倉庫。本專題透過兩機協同的物流場景，將課堂所學之機械原理實際應用：

1. **連桿機構設計**：Theo Jansen 仿生八足步行機構，探索 11 桿平面連桿機構的運動合成與最佳化。
2. **夾取機構設計**：齒輪齒條 (Rack and Pinion) 平行夾爪，結合 3D 列印與雷射切割。
3. **自動控制理論**：PID 控制器應用於 EV3 運輸機器人的黑線循跡。
4. **機電整合**：ESP32 + ESP-NOW + L298N + PCA9685 伺服驅動的模組化整合。
5. **團隊工程實務**：7 人團隊從設計、加工、組裝到測試的完整工程流程。

### 2.2 Theo Jansen 連桿機構

Theo Jansen Linkage 是由荷蘭動態雕塑家 Theo Jansen 透過**遺傳演算法 (Genetic Algorithm)** 最佳化的 **11 桿平面連桿機構**，將曲柄旋轉運動轉換為仿生步行軌跡。足端軌跡下半段近似水平直線（接地段 ≥ 60%），上半段為橢圓弧。

```
              固定支點 O
                 ●
                /|\
               / | \
           a  /  |  \ b
             /   |   \
            ● M  |  N ●
           /|    |    |\
       e  / |    |c   | \ d
         /  |    |    |  \
    J ●─/─  |    |    |  \─── K ●
      | f\  |g   |    |h /|
      |   \ |    |    | / |
      |    ●─────●────●  |
      |    L     P     Q  |
      |         / \       |
   i  |        /   \      | j
      |       /     \     |
      ●──────●       ●────●
      R      足端 F        S
```

#### 與 Chebyshev 機構比較

| 特性 | Chebyshev (四桿) | Theo Jansen (11 桿) |
|---|---|---|
| 接地段比例 | ~50% | **~60%+** |
| 步行穩定性 | 三角步態 6 足 | **交替步態 8 足** |
| 適用性 | 高速輕量 | **負載穩定** ✅ |

#### 11 Holy Numbers（縮放因子 0.7）

| 連桿代號 | Holy Number | ×0.7 (mm) | 說明 |
|---|---|---|---|
| a (Crank) | 38.0 | 26.6 | 曲柄 |
| b | 41.5 | 29.1 | O→N |
| c | 39.3 | 27.5 | 固定桿 |
| d | 40.1 | 28.1 | N→K |
| e | 55.8 | 39.1 | M→J |
| f | 39.4 | 27.6 | J→L |
| g | 36.7 | 25.7 | M→L |
| h | 65.7 | 46.0 | N→Q |
| i | 49.0 | 34.3 | L→F |
| j | 50.0 | 35.0 | K→S |
| k | 61.9 | 43.3 | Q→F |

### 2.3 夾取機構技術

| 類型 | 優點 | 缺點 | 適用 |
|---|---|---|---|
| **平行型夾爪** | 夾持力均勻 | 機構稍複雜 | ✅ 本組 |
| 成角型夾爪 | 結構簡單 | 力隨開口變化 | 固定尺寸 |
| 真空吸附 | 非接觸 | 需氣源 | 平面品 |
| 磁性夾持 | 無接觸力 | 僅限金屬 | 鐵磁材料 |

本組選擇**齒輪齒條 (Rack and Pinion) 雙向平行夾爪**：370 直流減速馬達具自鎖效應，斷電仍維持夾緊；搭配微動開關 (Limit Switch) 極限保護。

### 2.4 PID 控制原理

$$u(t) = K_p \cdot e(t) + K_i \cdot \int_0^t e(\tau)\,d\tau + K_d \cdot \frac{de(t)}{dt}$$

| 項 | 控制作用 | 過大影響 | 過小影響 |
|----|---|---|---|
| P | 即時修正偏差 | 震盪 | 跟蹤慢 |
| I | 消除穩態誤差 | 積分飽和 | 殘留偏移 |
| D | 抑制突變 | 噪音放大 | 無阻尼 |

本組使用單感測器左緣循跡法，目前調校參數：`KP=0.85`, `KI=0.01`, `KD=0.5`, `BASE_SPEED=110 mm/s`。

### 2.5 主控板選擇分析

在過往的專題中，Arduino Uno 常被作為控制板選擇，但其存在以下瓶頸：運算能力不足、無內建無線通訊、記憶體容量有限、無法有效多工處理、擴展性與整合能力較低。這些限制在本次多馬達控制與無線通訊的場景下將成為嚴重的效能瓶頸。

本組選擇 **ESP32** 作為主控板，其相較 Arduino 具有以下優勢：

| 特性 | ESP32 | Arduino Uno/MEGA |
|---|---|---|
| 運算效能 | 雙核心 240MHz | 單核心 16MHz |
| 無線通訊 | 內建 Wi-Fi / 藍芽 | 需外接模組 |
| 記憶體 | 520KB SRAM + 4MB Flash | 8KB SRAM + 256KB Flash |
| 多工處理 | FreeRTOS 支援 | 無原生支援 |
| 擴展性 | 高整合度 | 較低 |

### 2.6 ESP-NOW 無線通訊

採用 **ESP-NOW** 協議實現 ESP32 控制板之間的點對點無線通訊，不需透過 Wi-Fi 路由器即可進行低延遲資料傳輸。透過模組化架構，ESP32 主控板負責馬達控制與遙控接收，ESP32 C3 子控板負責 Z 方向與夾爪指令，兩者透過 ESP-NOW 協調運作。此外，ESP32 內建藍芽可搭配專用遙控 App 進行手機操控。

---

## 三、組員工作分配

| 任務項目 | 人員 |
|---|---|
| ESP32 程式開發、L298N 接線、ESP-NOW 通訊、電源系統 | 鍾沅駿 |
| PCA9685 整合、遙控 App、電壓監測、電源走線管理 | 陳翊家 |
| 夾爪設計（齒輪齒條）、3D 列印、齒輪配合、抓力調適 | 李耿泓 |
| 手臂滑軌設計、SolidWorks 建模、限位開關 | 吳昆哲 |
| 承物台設計（絞鏈+伸縮桿）、組裝調整、乘載盒製作 | 詹澄汯 |
| 八足 Theo Jansen 連桿設計、壓克力雷切、底盤組裝、Ansys 模擬 | 王子睿、陳翊家 |
| EV3 底盤組裝、輸送帶機構、裝載盒設計、PID 循跡程式調校 | 鍾沅駿、陳昱辰 |

---

## 四、進度規劃

以下為 17 週開發時程甘特圖：

| 週次 | 日期 | 取物機器人 | 運輸機器人 | 📌 繳交 |
|---|---|---|---|---|
| W1~2 | 2/24~3/3 | 分組、概念設計、軟體安裝 | 同左 | |
| W3~4 | 3/10~3/17 | 連桿設計、馬達選型、採購 | EV3 借用申請 | |
| W5 | 3/24 | 壓克力雷切、3D 列印 | 底盤組裝 | |
| W6 | 3/31 | 底盤組裝、手搖測試 | 感測器安裝 | |
| | **4/2 (四)** | | | **📌 專題計劃書** |
| W7 | 4/7 | 電控接線（L298N+步行馬達） | 輸送帶組裝 | |
| W8 | 4/14 | 藍芽測試、App 開發 | PID 調校 | |
| W9 | 4/21 | App 完成、手臂設計加工 | 停止線偵測測試 | |
| W10 | 4/28 | 手臂整合、伺服校正 | 輸送帶測試 | |
| W11 | 5/5 | **首次雙機聯合測試** | **首次雙機聯合測試** | |
| W12 | 5/12 | 問題修正 | 問題修正 | |
| | **5/15 (五)** | | | **📌 期中報告** |
| W13~14 | 5/19~5/26 | 反覆測試、操作優化 | 參數最佳化 | |
| W15~16 | 6/2~6/9 | 模擬比賽、計時演練 | 最終調校 | |
| W17 | 6/15 | **🏆 期末競賽** | **🏆 期末競賽** | |
| | **6/26 (五)** | | | **📌 期末報告** |

---

## 五、設計概念草圖

### 5.1 取物機器人 — 系統架構

```
手機遙控 App（ESP32 內建藍芽）
    │
    ▼
ESP32（主控板）                         ESP32 C3（子控板）
    │  ┌── 馬達控制                         │  ┌── Z 方向控制
    │  ├── 遙控接收                         │  └── 夾爪指令
    │  └── 夾爪指令發送 ──── ESP-NOW ────→  │
    │                                       │
    ├── L298N (板A) → JGB37-520 左側 4 足   ├── L298N (板B) → XD-25GA 370 手臂/夾爪
    ├── Limit Switch → 夾爪極限保護          │
    ├── PCA9685 (I2C)
    │   └── SG90 承物台傾斜
    ├── LM2596 降壓模組 → 5V 供 ESP32 + 伺服馬達
    └── 電源：18650 鋰電池 × 4
```

透過 ESP-NOW 讓各個 ESP 控制板之間不需 Wi-Fi 即可做點對點通訊，在功能上設計模組化的系統。

### 5.2 取物機器人 — 八足步行機構

```
  俯視圖（↑ = 前進方向）

       前
  足1 ── 足5       左側（足1~4）→ 馬達 A (JGB37-520)
   |      |
  足2 ── 足6       右側（足5~8）→ 馬達 B (JGB37-520)
   |      |
   足3 ── 足7       原地旋轉轉向
    |      |
   足4 ── 足8       交替步態：同側相位差 90°，左右錯開 180°
       後
```

- 底盤材料：5mm 壓克力（雷切）、連桿片 3mm 壓克力
- 轉軸：M3 螺絲 + 尼龍墊圈
- 估算尺寸：長 ≈ 280mm、寬 ≈ 260mm（在 400×400mm 限制內）

### 5.3 取物機器人 — 夾取機構

```
側視圖：

         ┌─── 夾爪 ───┐
         │ [齒條齒輪]   │  ← 上層：齒輪齒條平行夾爪 + 滑軌手臂
    ─────┤             ├─────
         │  [承物台]    │  ← 下層：可傾斜承物台
    ─────┤  ↙ 絞鏈    ├─────     （一側絞鏈 + 一側伸縮桿）
         └─────────────┘
    ─────── 底盤 + 8 足 ───────
```

- **夾爪**：齒輪齒條 (Rack and Pinion) 雙向平行，3D 列印夾爪板 + 雷切齒輪 + 外購齒條
- **驅動**：XD-25GA 370 DC 減速馬達，自鎖效應保持夾緊
- **安全**：微動開關 (Limit Switch) 硬體保護 + 軟體 Timeout 保護
- **增摩**：高密度海綿 + 矽膠止滑墊
- **開口**：> 32mm（覆蓋所有零件外徑）

### 5.4 運輸機器人 — 系統架構

```
EV3 Brick (Pybricks MicroPython)
    ├── Port D: 左輪大馬達（輪徑 56mm）
    ├── Port C: 右輪大馬達（輪徑 56mm）
    ├── Port A: 輸送帶中馬達（頂部水平輸送帶）
    ├── Port S1: 前下顏色感測器（循跡+停止線，離地 5~10mm）
    └── Port S4: 觸碰感測器（啟動/零件偵測）
```

### 5.5 運輸機器人 — 機構佈局

```
        前方（行進方向 →）
    ┌──────────────────────┐
    │     [S1 前下感測器]    │  ← 顏色感測器朝下
    │   ┌────────────┐    │
    │   │  輸送帶帶面  │    │  ← 頂部水平輸送帶 (Motor A)
    │   │  →→→→→→  │    │    零件往外側推落
    │   └────────────┘    │
    │        EV3 Brick      │
    │  ◎左輪          右輪◎ │  ← Port D, C
    │     ● 萬向輪         │
    │   [觸碰感測器 S4]    │
    └──────────────────────┘
```

### 5.6 運輸機器人 — 輸送帶

```
側視圖：
                零件
     → → → → [■] → → 推落至放置區平台
    ┌═══════════════┐
    │  履帶帶面         │ ← LEGO 履帶組
    └═══════════════┘
    ◎驅動輪          ○惰輪
    (Motor A)
```

- 驅動輪靠內側（接收端），惰輪靠外側（推落端）
- 程式參數：`CONVEYOR_SPEED = 300 deg/s`、`CONVEYOR_RUN_TIME = 3000 ms`

### 5.7 雙機協同流程

```
取物機器人（遙控）                    運輸機器人（自動）
────────────────                   ────────────────
1. App 連線 ESP32                    1. 觸碰感測器啟動
2. 步行至貨架                        2. 等待於起點
3. 手臂/夾爪夾取零件                  │
4. 暫存至承物台                       │
5. 步行至運輸機器人旁                  │
6. 傾斜承物台倒入輸送帶  ──────→    3. 觸碰感測器觸發
                                      4. PID 循跡至放置區（黃線）
                                      5. 停車，啟動輸送帶推落零件
                                      6. 繼續循跡返回起點（紅線）
7. 繼續取件（重複 2~6）  ←──────    7. 停車等待下一輪
```

### 5.8 遙控 App 介面

採用 ESP32 內建藍芽搭配專用遙控 App，透過手機控制取物機器人的步行與手臂動作。App 介面包含步行控制（前進、後退、原地左旋、原地右旋）、手臂控制（上下、伸縮）、夾爪控制（開合）、承物台控制（傾斜/水平）等功能區塊。

---

## 六、總預算規劃

### 取物機器人

| 項目 | 單價 (NT$) | 數量 | 金額 (NT$) | 用途詳述 |
|---|---|---|---|---|
| ESP32 開發板 | 189 | 1 | 189 | 主控板，馬達控制/遙控接收/夾爪指令發送 |
| ESP32 C3 開發板 | 100 | 1 | 100 | 子控板，Z 方向控制/夾爪指令接收（ESP-NOW） |
| L298N 馬達驅動板 | — | 2 | 0 | **(現有)** 板A 驅動步行馬達，板B 驅動手臂/夾爪馬達 |
| PCA9685 伺服驅動板 | 60 | 1 | 60 | I2C 控制承物台伺服馬達 |
| JGB37-520 直流減速馬達 | — | 2 | 0 | **(現有)** 12V 100RPM 步行驅動 |
| XD-25GA 370 直流減速馬達 | — | 2 | 0 | **(現有)** 12V 50RPM 手臂/夾爪，自鎖 |
| MG996R 伺服馬達 | 120 | 2 | 240 | 肩/肘關節備用方案（金屬齒輪高扭力）|
| MG996R 舵機盤 | 35 | 2 | 70 | 搭配 MG996R 使用，25T 鋁合金圓型 |
| SG90 伺服馬達 | 50 | 1 | 50 | 承物台傾斜控制（輕量小型）|
| 18650 松下鋰電池 | 179 | 4 | 716 | 腿部機構/夾爪操控電源供應 |
| 鋰電池充電器 | 100 | 1 | 100 | 電源供應補充 |
| 18650 四節電池盒 | 28 | 1 | 28 | 機器人用 |
| LM2596 降壓模組 | 30 | 1 | 30 | 可調輸出，將電池電壓降至 5V 供 ESP32 |
| 壓克力板 3mm | 50~100 | 4 | 200~400 | 連桿片雷射切割（八足需大量）|
| 壓克力板 5mm | 80 | 1 | 80 | 底盤結構 |
| M3 螺絲/螺帽/墊圈 | — | 各包裝 | 120 | 連桿軸銷及組裝固定 |
| 軸承 (3mm 內徑) | 10 | 16 | 160 | 八足曲柄軸用，減少摩擦 |
| 齒條 | 50 | 2 | 100 | 夾爪線性運動用，配合雷切齒輪 |
| 直線滑軌 MGN12 | 200 | 1 | 200 | 手臂線性伸縮軌道 |
| 海綿 + 止滑墊 | — | 各 1 | 50 | 夾爪內側增加摩擦力 |
| 絞鏈 + 伸縮桿 | — | 各 2/1 | 50 | 承物台傾斜機構 |
| 承物台板材 | 60 | 1 | 60 | 壓克力 3mm |
| 杜邦線 + 電源線 + 電阻 | — | — | 92 | 連接線材 |

### 運輸機器人

| 項目 | 單價 (NT$) | 數量 | 金額 (NT$) | 用途詳述 |
|---|---|---|---|---|
| EV3 全套件 | 0 | 1 套 | 0 | **學校借用**，含 Brick、馬達、感測器、結構件、履帶組 |
| microSD 卡 | 100 | 1 | 100 | ≥16GB Class 10，安裝 Pybricks |
| USB 線 (Mini-B) | 50 | 1 | 50 | 連接 EV3 到電腦 |
| 黑色電氣膠帶 | 30 | 1 卷 | 30 | 19mm 寬，場地軌跡黑線 |
| 黃色/紅色色紙膠帶 | 20 | 各適量 | 40 | 放置區/起點停止線 |
| AA 充電電池 1.2V | 40 | 6 | 240 | NiMH，EV3 Brick 供電 |
| | | **小計** | **~460** | |

### 合計

| 項目 | 金額 (NT$) |
|---|---|
| 取物機器人 | ~3,400~4,200 |
| 運輸機器人 | ~460 |
| **合計** | **約 3,900~4,700** |

> **備註**：校內壓克力雷切費用可能免費。

### 目前經費執行情況（截至 2026/03/29）

| 項目 | 金額 (NT$) |
|---|---|
| 目前總經費 | 10,000 |
| 目前已花費 | 1,767 |
| 剩餘經費 | 8,233 |
| 經費使用率 | 17.67% |

> 目前實際採買以取物機器人原型與共用工具、耗材為主；運輸機器人目前仍以學校借用 EV3 套件開發。

### 已完成採買項目

| 採買品項 | 採買日期 | 採買數量 | 單價 (NT$) | 總價格 (NT$) |
|---|---|---|---|---|
| WD-40 | 2026/03/02 | 1 | 188 | 188 |
| 活動板手 | 2026/03/02 | 1 | 95 | 95 |
| 18650 松下鋰電池 | 2026/03/14 | 4 | 179 | 716 |
| 鋰電池充電器 | 2026/03/14 | 1 | 100 | 100 |
| 18650 四節電池盒 | 2026/03/14 | 1 | 28 | 28 |
| ESP32 開發版 | 2026/03/14 | 1 | 189 | 189 |
| 杜邦線 | 2026/03/14 | 1 | 37 | 37 |
| ABS 3D 列印線材 | 2026/03/23 | 1 | 369 | 369 |
| 運費 | 2026/03/23 | 1 | 45 | 45 |
| **合計** |  |  |  | **1,767** |

---

## 七、參考文獻

1. Theo Jansen, *The Great Pretender*, NAi010 Publishers, 2007.
2. Jansen's Linkage — Wikipedia, https://en.wikipedia.org/wiki/Jansen%27s_linkage
3. Theo Jansen's Strandbeest Official Website, https://www.strandbeest.com/
4. S. Nansai, R. Elara, M. Iwase, "Dynamic Analysis and Modeling of Jansen Mechanism," *Procedia Engineering*, Vol. 64, 2013, pp. 1562–1571.
5. K. Ogata, *Modern Control Engineering*, 5th Edition, Pearson, 2010.（PID 控制理論）
6. Pybricks Documentation — EV3 MicroPython, https://pybricks.com/ev3-micropython/
7. LEGO MINDSTORMS EV3 Hardware Developer Kit, https://education.lego.com/
8. Adafruit PCA9685 16-Channel PWM Servo Driver Library, https://github.com/adafruit/Adafruit-PWM-Servo-Driver-Library
9. MIT App Inventor — Build Apps for Android, https://appinventor.mit.edu/
10. HC-05 Bluetooth Module Datasheet, Guangzhou HC Information Technology Co., Ltd.
11. L298N Dual Full-Bridge Driver Datasheet, STMicroelectronics.
12. 2021 屆成功大學機械專題實作學長資料（底盤及吸氣馬達程式、手臂及伺服馬達程式、操作 App）。
