e14121040-netizen/2026-NCKU-ME-PROJECT/開會紀錄/0421.md

# 會議紀錄 — 0421

> **日期**：2026 / 04 / 21  
> **出席**：（請補充出席人員）  
> **主持**：  
> **記錄**：

---

## 議程

1. ZClawController 完成確認
2. MainController_BLE 完成確認
3. 專案文件全面完善
4. 下階段計畫

## 討論內容

### 1. ZClawController (C3 #3)

- z/夾爪子控板程式已完成
- 功能包含：z 升降（DC 馬達）、夾爪伺服、蓋板伺服
- 安全機制：限位開關 + Timeout 保護 + 歸位功能
- （請補充測試結果）

### 2. MainController_BLE

- BLE UART Service 版主控板已完成
- 支援 BLE + ESP-NOW 共存
- 新增字串指令格式（FORWARD, BACKWARD, STOP, SPD:xxx 等）
- 與 BluetoothSerial 版指令相容
- （請補充測試結果）

### 3. 專案文件完善

- 所有文件中的指令表已同步更新為新版圓柱座標指令
- 移除所有 PCA9685 殘留參考
- 新增共用 `protocol.h` 標頭檔
- 新增 MAC 地址佔位符啟動警告
- esp32控制/README.md 補充版本需求與已知限制
- 主 README 目錄結構更新

### 4. 下階段計畫

- 手臂機構設計與製作
- App 開發
- 期中報告撰寫（截止 5/15）
- （請補充具體分工）

## 工作分配 / 待辦事項

| 負責人 | 事項 | 截止日 |
|---|---|---|
| （請補充） | 手臂結構 SolidWorks 設計 | 4/28 |
| （請補充） | 遙控 App 開發 | 4/28 |
| （請補充） | C3 #2 / C3 #3 MAC 地址取得填入 | 4/28 |
| （請補充） | 期中報告章節分工 | 5/5 |

## 下次開會

- **日期**：2026/04/28
- **議程預告**：手臂加工進度、App 測試、期中報告分工
