e14121040-netizen/2026-NCKU-ME-PROJECT/開會紀錄/每週開會主題計畫.md

# 每週開會主題計畫

> 根據課程進度表（18 週）和[開發步驟指南](../開發步驟指南.md)排定。  
> 📌 繳交節點已標記，務必提前準備。
>
> ❗ **繳交截止時間**：
> - 會議紀錄：每週五 17:00
> - 專題計劃書：2026/04/02 (四) 17:00
> - 期中報告：2026/05/15 (五) 17:00
> - 期末報告：2026/06/26 (五) 17:00

---

## Week 1（2/24）✅ 已完成

**啟動 — 分組 & 規則研讀**

- [x] 專案分工確認（電控 / 夾爪 / 底盤）
- [x] 競賽規則研讀（足型、尺寸限制、計分方式）
- [x] 討論機構方案 → 確定 Theo Jansen 八足
- [x] 建立 GitHub 專案

---

## Week 2（3/3）

**環境準備 & 概念設計啟動**

> 📚 課程：工程設計程序與歷屆專題回顧 / 拆解舊機器人

- [x] 各組員開發環境安裝（Arduino IDE 或 VS Code + Arduino 擴充）
- [x] BOM 零件採購啟動
- [x] 研究學長機器人（拆解舊機器人課程）
- [x] 開始撰寫**專題計劃書**（Week 6 繳交）
- [ ] 概念設計草圖：底盤 + 手臂初步構想

---

## Week 3（3/10）

**底盤設計 & 馬達選用**

> 📚 課程：馬達選用簡介

- [ ] Python Theo Jansen 連桿可視化 → 確認最終連桿參數
- [x] 選定直流馬達型號（RPM、扭力確認）
- [ ] SolidWorks 連桿片 2D 圖開始繪製
- [x] EV3 套件借用
- [x] 專題計劃書：概念設計、系統架構章節

---

## Week 4（3/17）

**電控設計 & 加工準備**

> 📚 課程：馬達驅動與控制概述

- [ ] SolidWorks 連桿片 + 底盤完成 → 匯出 DXF
- [x] 電控系統設計確認（接線圖複習）
- [ ] 雷射切割預約 / 送件
- [x] 專題計劃書：細部規劃、零件圖章節

---

## Week 5（3/24）

**加工 & 組裝啟動**

> 📚 課程：電腦輔助機械設計

- [ ] 雷射切割完成 → 取件
- [ ] 八足底盤組裝開始
- [ ] EV3 底盤組裝開始（可並行）
- [ ] 專題計劃書：加工規劃書、經費規劃章節
- [ ] 專題計劃書**初稿完成** → 組內審閱

---

## Week 6（3/31）

**底盤完成 & 計劃書收尾**

> 📢 課程：機械工廠加工說明
> ⚠ **專題計劃書截止：4/2 (四) 17:00**

- [x] **繳交專題計劃書**
- [ ] 八足底盤組裝完成 → 手搖測試
- [ ] 確認 Theo Jansen 足端軌跡正確、機體尺寸 < 400×400mm
- [ ] EV3 底盤 + 感測器安裝進度

---

## Week 7（4/7）🌸 春假週

> 📚 春假 (4/3~4/8)，但仍有分組討論與實作課

- [x] L298N + 直流馬達接線
- [x] ESP32 藍芽基本連線測試
- [x] ESP32 程式上傳 + 馬達方向測試
- [ ] 利用假期趕工！

---

## Week 8（4/14）

**電控完成 & App 開發**

- [x] 全部接線完成（含 L298N ×3 + 伺服馬達）
- [x] 藍芽遥控步行測試（前進/後退/轉向）
- [ ] App Inventor 開發啟動
- [x] EV3：PID 循跡初步調校

---

## Week 9（4/21）

**App 完成 & 手臂設計**

- [ ] App 步行 + 手臂按鈕全部測試通過
- [ ] 匯出 `.apk` 安裝到手機
- [ ] 手臂結構設計（SolidWorks）
- [ ] EV3：黃色/紅色停止線偵測測試
- [ ] 開始準備**期中報告**（Week 12 繳交）

---

## Week 10（4/28）

**手臂加工 & 整合**

- [ ] 手臂零件加工 + 組裝
- [ ] 安裝到底盤 → 重心測試
- [ ] 伺服角度參數校正
- [ ] EV3 放置機構測試
- [ ] 期中報告：設計過程、實作進度章節

---

## Week 11（5/5）

**首次聯合測試 & 期中報告準備**

- [ ] 步行 + 手臂同時操作測試
- [ ] EV3 全流程測試（循跡 → 停車 → 放置 → 返回）
- [ ] **首次雙機聯合測試**
- [ ] 紀錄問題清單 → 修正
- [ ] 期中報告**初稿完成** → 組內審閱

---

## Week 12（5/12）

**聯合測試 & 期中報告收尾**

> ⚠ **期中報告截止：5/15 (五) 17:00**

- [ ] **繳交期中報告**
- [ ] 聯合測試問題修正
- [ ] 第一次完整計時紀錄

---

## Week 13（5/19）

**優化 & 反覆測試**

- [ ] 操作員練習 → 優化操作流程
- [ ] 第二次計時紀錄（目標：比第一次快）
- [ ] PID 參數微調 → 固定最終值
- [ ] 手臂角度微調 → 固定最終值

---

## Week 14（5/26）

**全速測試 & 策略制定**

- [ ] 全速模擬比賽（8 分鐘計時）
- [ ] 比賽策略討論：先夾哪種零件最快？
- [ ] 開始撰寫**期末報告**
- [ ] 開始設計海報

---

## Week 15（6/2）

**期末報告撰寫 & 備品**

- [ ] 期末報告撰寫進度（分工：誰寫哪章）
- [ ] 海報初稿完成
- [ ] 備品清點（對照[比賽當天 Checklist](../文件/比賽當天Checklist.md)）
- [ ] 全隊模擬演練 ×1

---

## Week 16（6/9）

**最終準備 — 競賽前一週**

- [ ] 期末報告初稿完成 → 全組審閱
- [ ] 海報定稿 → 送印
- [ ] 機器人標記「**乙-2**」
- [ ] 全隊模擬演練 ×2（計時）
- [ ] 電池全部充滿、工具箱確認

---

## Week 17（6/15）🏆 各班期末競賽

**比賽日！**

- [ ] 對照[比賽當天 Checklist](../文件/比賽當天Checklist.md) 做最後確認
- [ ] 電池充滿、備品齊全
- [ ] **三輪競賽**（取最高分）

---

## Week 18（6/22）

**期末報告 & 實作展準備**

> ⚠ **期末報告截止：6/26 (五) 17:00**
> 📌 6/27 (六) 實作展（成績前 50% 需參賽）

- [ ] **繳交期末報告**
- [ ] 確認是否進入實作展競賽組
- [ ] 如需參加實作展：最終調校 + 準備

---

## 專案進度甘特圖 (Gantt Chart)

```mermaid
gantt
    title 2026 NCKU ME PROJECT
    dateFormat  YYYY-MM-DD
    axisFormat  %m/%d

    %% ===== 基礎 =====
    section 基礎
    啟動分組        :done,   2026-02-24, 7d
    環境準備        :active, 2026-03-03, 14d

    %% ===== 八足 =====
    section 八足機器人
    底盤設計        :2026-03-10, 14d
    雷切加工        :2026-03-24, 14d
    底盤測試        :2026-03-24, 14d
    馬達接線        :2026-04-07, 7d
    藍芽測試        :2026-04-14, 7d
    App開發         :2026-04-14, 14d
    手臂設計        :2026-04-21, 7d
    手臂整合        :2026-04-28, 7d
    伺服校正        :2026-04-28, 7d
    聯合測試        :2026-05-05, 7d

    %% ===== EV3 =====
    section 運輸機器人
    底盤組裝        :2026-03-24, 14d
    感測安裝        :2026-03-31, 7d
    PID調校         :2026-04-14, 7d
    停止測試        :2026-04-21, 7d
    放置測試        :2026-04-28, 7d
    全流程測試      :2026-05-05, 7d

    %% ===== 整合 =====
    section 系統整合
    接力測試        :crit, 2026-05-05, 7d
    問題修正        :2026-05-12, 7d
    操作優化        :2026-05-19, 7d
    模擬比賽        :crit, 2026-05-26, 7d
    計時演練1       :2026-06-02, 7d
    計時演練2       :2026-06-09, 7d

    %% ===== 文件 =====
    section 文件
    計劃書撰寫      :2026-03-03, 28d
    計劃書截止      :milestone, 2026-04-02, 0d
    期中報告        :2026-04-21, 21d
    期中截止        :milestone, 2026-05-15, 0d
    期末報告        :2026-05-26, 28d
    海報製作        :2026-05-26, 21d
    期末競賽        :milestone, 2026-06-15, 0d
    報告截止        :milestone, 2026-06-26, 0d
    專題展          :milestone, 2026-06-27, 0d
