e14121040-netizen/2026-NCKU-ME-PROJECT/開會紀錄/0324.md

# 會議紀錄 — 0324

> **日期**：2026 / 03 / 24 09:00  
> **出席**：吳昆哲、鍾沅駿、李耿泓、陳翊家、王子睿、陳昱辰、詹澄汯  
> **主持**：李耿泓  
> **記錄**：吳昆哲

---

## 議程

1. 夾爪圖完成
2. 計劃書
3. 運輸機
4. 取物機腿部

## 討論內容

### 1. 夾爪圖完成

- 夾爪圖已完成。
- 目前圖面包含以下結構：
  - 夾片
  - 橫臂
  - 直臂
- 參考圖如下：

螢幕擷取畫面 2026-03-27 152434

### 2. 計劃書

- 甘特圖完成。
- 整體架構完成。

### 3. 運輸機

- 持續調整 PID 參數。
- 持續改善紅黃線判定。

### 4. 取物機腿部

- 電控進度：
  - 腿部馬達控制雛形已出。
- 機構進度：
  - 仿足腿部控制雛形已出。

## 下週目標

- 腿部接線測試。
- 導入手機程式控制。
- 腿部確認。
- 計算腿部齒輪幾何參數。
