e14121040-netizen/2026-NCKU-ME-PROJECT/開會紀錄/0317.md

## 0317
:::info
- **Date :** [time= 2022 03 17 09:00]
- **Attendency**
[name= 吳昆哲、鍾沅駿、李耿泓、陳翊家、王子睿、陳昱辰、詹澄汯]
主持 : 李耿泓
記錄 : 吳昆哲
- **Agenda**
1. 夾爪作圖
2. 配重模擬
3. 取物機底盤
4. 取物機腿部機構模擬
5. 運輸機EV3設定
:::
- 夾爪作圖進度
    - 夾爪：
        - 夾爪裝配、干涉情況模擬，夾爪零件建議加工方法：3D列印[部分零件需要切分後個別列印，以避免出現懸空部分(也可在懸空部分使用支撐但效果未知)]。
        - 確認夾爪手臂形式[水平伸縮臂(可使用滑軌但現有滑軌過重需重新購買滑軌)+垂直臂(齒輪+齒條 齒條尺寸較大需使用雷射切割加工 思考如何使用單一馬達驅動兩側齒輪齒條組)]。
        - 繪製垂直臂機構零件圖，建議加工方法：雷射切割。
        - 完成夾爪、垂直臂裝配模擬。
    - 機械手臂
        - 確認乘載夾爪平台和轉動機構，並繪製組合件
        - 橫直手臂皆繪製完畢，待組合
    - 整體架構
        - 已確認製作樣式且大致繪製完成
- 配重模擬
- 取物機底盤
    - 做最佳化，下禮拜完成底盤的設計
- 取物機腿部機構模擬
    - 找腿部機構的相關論文做最佳化
    - 腿部機構建模
    - 機構運動模擬
- 運輸機EV3設定
    - 韌體與連線：重刷 Pybricks 韌體至 microSD 卡，成功使用 VS Code 與 EV3 的連線及程式上傳功能。
    - 硬體防呆：新增 HAS_PLACE_MOTOR 開關，設為 False 可跳過 Port A 初始化並啟用模擬放置，方便單獨測試車台。
    - 腳位調整：左輪馬達移至 Port D，並確認雙輪皆設為 Direction.CLOCKWISE 確保推進方向一致。
    - PID 循跡降速求穩：降低基礎速度與 PID 參數以減少車體擺動（BASE_SPEED: 100 ➔ 60；KP: 1.2 ➔ 0.6；KI: 0.0；KD: 0.5 ➔ 0.3；轉向係數: 2 ➔1）。
    - 防彈跳 (Debounce)：新增 yellow_count 機制，需連續偵測到黃色才判定為停止線，避免環境光誤判。
    - 跨線防連停：在黃線放置與紅線等待觸發後，強制執行 robot.straight(25) 跨越標線。
    - 系統中斷機制：將長秒數的 wait() 改寫為短秒數的 for 迴圈（如 20 x 100ms），確保程式能成功捕捉硬體 Back 鍵的 KeyboardInterrupt 中斷指令。
    - 流程控制：主程式改為 while True 無限迴圈，螢幕僅顯示累計總放置次數。
    - 後續待辦事項
    - 以目前的慢速穩定版為基礎，逐步調高 BASE_SPEED 與 KP。
放置機構組裝完成後，將 HAS_PLACE_MOTOR 設回 True 進行全機測試。
