e14121040-netizen/2026-NCKU-ME-PROJECT/開會紀錄/0303.md

# 0303 會議記錄

> **日期**：2026 / 03 / 03  
> **出席**：吳昆哲、鍾沅駿、李耿泓、陳翊家、王子睿、陳昱辰、詹澄汯  
> **主持**：李耿泓  
> **記錄**：吳昆哲

---

## 議程

1. 雲端儲存
2. 甘特圖
3. 進度分享
4. 控制方式
5. 品質屋
6. 臨時動議

## 討論內容

### 1. 足部機構變更決策

- **決定將步行機構從 Chebyshev 六足改為 Theo Jansen 八足（Spider Robot）**
    - 原因：八足步行更穩定、Theo Jansen 機構足端軌跡更仿生
    - 驅動方式不變：左右各 1 顆直流馬達，差速轉向
    - 八足配置：左側 4 足 + 右側 4 足，同側每足曲柄相位差 90°
    - 連桿參數採用 Theo Jansen 11 Holy Numbers（縮放因子 0.7）
    - 已更新所有專案文件和 GitHub 資料，詳見 [TheoJansen連桿設計參考.md](../取物機器人(八足Jansen)/機構設計/TheoJansen連桿設計參考.md)

### 2. 夾爪樣式

- 二夾爪：平行版+海綿+止滑墊
    - 砂紙止滑效果可能欠佳
    - 三夾爪抓圓形物效果可能比較好
    - 平行夾爪構造
- 直流馬達、伺服馬達比較
- 差速馬達
- 滑軌控制前後

### 3. 底盤

- 承物台
    - 做成可傾斜式
    - 一側絞鍊、一側用伸縮桿

### 4. 甘特圖

- [甘特圖連結](https://docs.google.com/spreadsheets/d/1RHza0QZjlB6mzyxCon25qMpc4-A8cu9OjGGf4zatYu8/edit?usp=sharing)
- 甘特圖參考去年學長
- 每一組的實際進度還是依照自己的加工進度為主

### 5. 進度分享

- [夾爪](https://www.thingiverse.com/thing:2302957)、[手臂](https://www.instructables.com/Pointillist-Painting-Robot-Arm/)結構已大略確定
- 夾爪
    - 參考網路上的成品
    - 夾法、構造簡單
    - 會再決定馬達大小，做調整
- 手臂
    - 參考網路上的成品
    - 結構簡單都差不多、設計簡單
    - 可以依不同的馬達大小在結構上微調
- 整體結構
    - 分為兩層 — 夾爪（上層）、堆高機（下層）
    - 希望可以一次處理兩筆訂單下去設計
    - 尺寸會在下週可以拆學長姐的時候會再確認
- 運輸
    - 目前在方塊，循跡的第一版方塊已經完成（用 PID，還要調參數）
    - 運輸帶希望可以用超音波的感應去做
    - 需要跟堆高機的尺寸做確認

## 工作分配 / 待辦事項

| 負責人 | 事項 | 截止日 |
|---|---|---|
| 夾爪組 | 確認夾爪 → 整體結構之長寬 | 下次開會 |
| 運輸組 | 確認運輸機器人 → 堆高機尺寸（高度配合） | 下次開會 |

## 下次開會

- **日期**：待定
- **議程預告**：各組進度回報、尺寸確認
