e14121040-netizen/2026-NCKU-ME-PROJECT/開會紀錄/0310.md

# 會議紀錄 — 0310

> **日期**：2026 / 03 / 10 09:00  
> **出席**：吳昆哲、鍾沅駿、李耿泓、陳翊家、王子睿、陳昱辰、詹澄汯  
> **主持**：李耿泓  
> **記錄**：吳昆哲

---

## 議程

1. 樂高 EV3 組裝
2. 夾爪設計圖展示
3. 馬達測試
4. 進度分享
5. 共同目標與提醒
6. 臨時動議

## 討論內容

### 1. 樂高 EV3 組裝

- 組裝結果
- 行走測試：
  - 測試一：僅能旋轉 → 猜測是 4 號孔沒連接
  - 測試二：幾乎無法前進 → 猜測是沒電
  - 測試三：(未記錄)

### 2. 夾爪設計圖展示

- [參考照片](https://drive.google.com/file/d/1hNIuLVoCN1gkY-wMX75HxtRbdehWG9Xg/view?usp=drive_link)
- **改進方向**：
  - 接合處
  - 夾板形狀
  - 夾爪、手臂連接方案：
    - 滑輪（作廢）
    - 滑軌：手臂整條帶動（暫定）
- **改進方案**：
  - 前後檔板：往下加長擋住
  - 夾片：可以改變形狀
  - 連接處：改變形狀強化
  - 上下自由度
- **加工方法**：
  - 溝槽板：3D 列印
  - 夾爪板：3D 列印
  - 齒條：待訂
  - 齒輪：雷射切割

### 3. 馬達測試

- 直流馬達：全數存活 (4/4)
- 伺服馬達：待測試 (確認型號為 MG996r)

### 4. 進度分享

- **夾爪**：5cm
- **手臂**：60cm
- **堆高機**：兩邊同時升降，扣住籃子、兩個馬達
- **整體架構**：預計下禮拜完成圖檔
- **運輸**：方塊拉好、測試場地完成、下週開始測試、目前加強結構

### 5. 共同目標與提醒

- **目標**：這週完成所有圖檔，下周討論與展示，並報告預計加工進度。
- **提醒**：專題計劃書差不多可以慢慢開始寫了。

## 工作分配 / 待辦事項

| 負責人 | 事項 | 截止日 |
|---|---|---|
| 全體成員 | 完成所有圖檔 | 下週會議前 |

## 下次開會

- **日期**：下週（待定）
- **議程預告**：展示圖檔、報告預計加工進度
