e14121040-netizen/2026-NCKU-ME-PROJECT/開會紀錄/0224.md

# 會議紀錄 — 0224

> **日期**：2026 / 02 / 24  
> **出席**：吳昆哲、鍾沅駿、李耿泓、陳翊家、王子睿、陳昱辰、詹澄汯  
> **主持**：李耿泓  
> **記錄**：吳昆哲

---

## 議程

1. HackMD 專案頁面建立完成
2. 行程表確認
3. 臨時動議
4. 工作分配

## 討論內容

### 1. 規則討論與研究

- 討論不能使用輪型機器人的替代方案
- 目前替代方案：**Chebyshev 連桿機構（六足）**
- 討論機構穩定度問題：原 4 足改為 **6 足或 8 足**

### 2. 時程表確認

- 已確認本學期各階段時程

## 工作分配

| 負責人 | 事項 | 備註 |
|---|---|---|
| 鍾沅駿、陳翊家 | 電控 | |
| 李耿泓、吳昆哲、詹澄汯 | 夾爪 | |
| 王子睿、陳昱辰 | 底盤 | |

## 下次開會

- **日期**：待定
- **議程預告**：各組進度回報
