e14121040-netizen/2026-NCKU-ME-PROJECT/文件/報告/專題計畫書格式2026.docx.pdf

# 114學年度第二學期

# 機械專題實作

# 專題計劃書

班級:
組別:
組員學號: | 姓名 | 貢獻度(%)

合計100%

日期:

目錄

一、計畫目標 3

二、動機與文獻回顧 3

三、組員工作分配 4

四、進度規劃 5

五、設計概念草圖 | 6
六、總預算規劃 | 7

七、參考文獻 8

一、計畫目標

二、動機與文獻回顧

三、組員工作分配

人員
任務項目

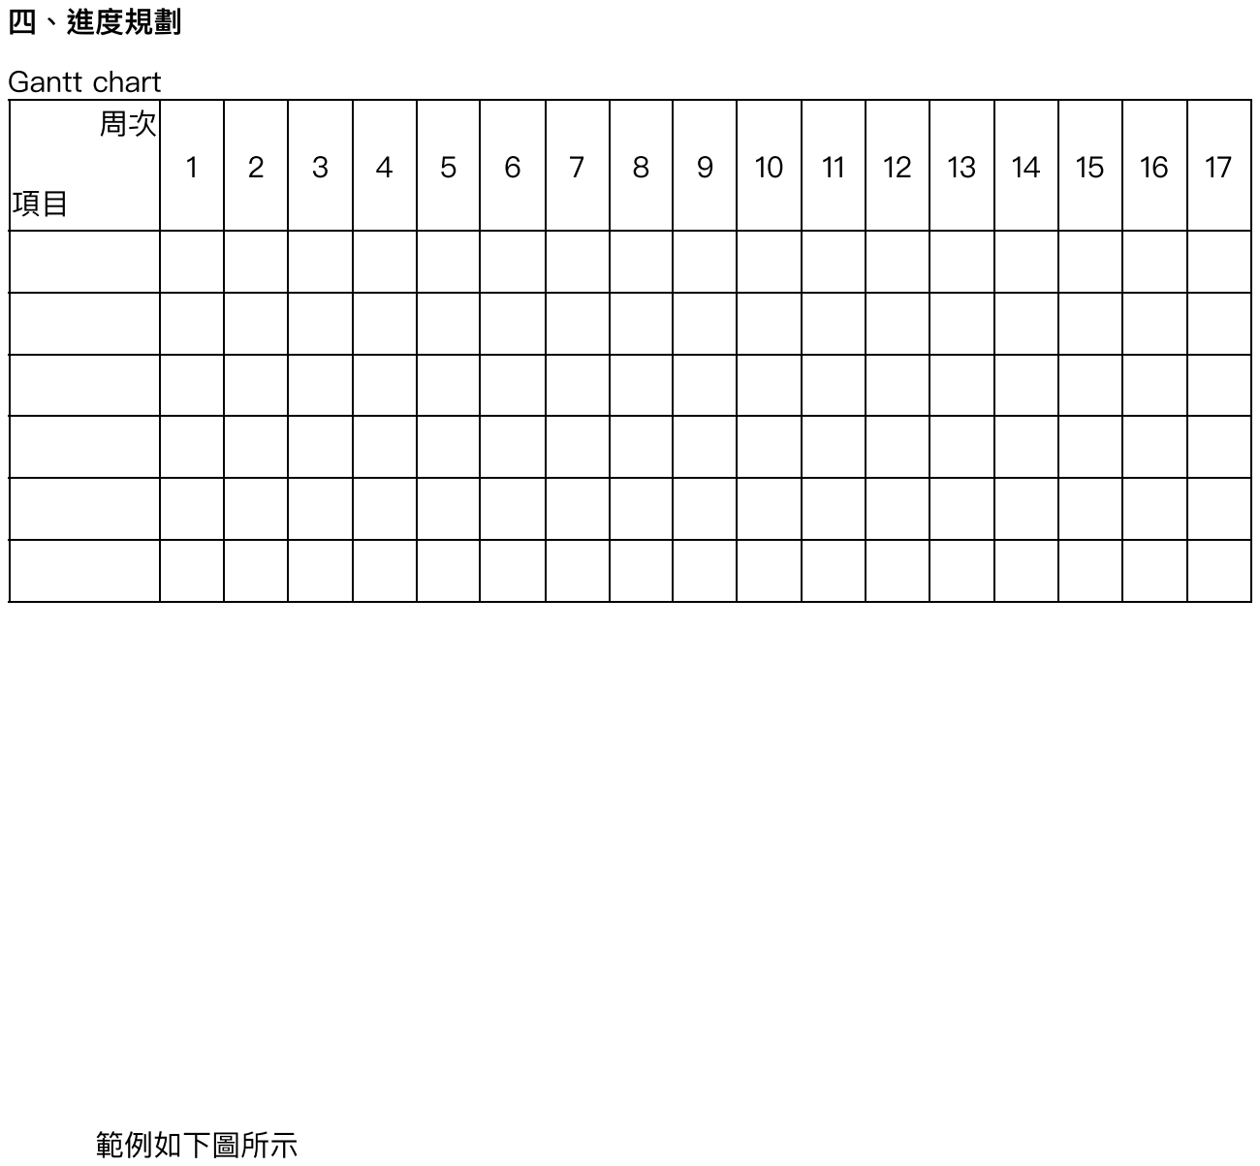
[picture p10: figure]
四、進度規劃; Gantt chart; 範例如下圖所示

五、設計概念草圖

六、總預算規劃

項目 | 單價 | 數量 | 金額 | 用途詳述

合計:

其他現有資源:

七、參考文獻
