e14121040-netizen/2026-NCKU-ME-PROJECT/文件/報告/期中報告格式2026.docx.pdf

# 114學年度第二學期 機械專題實作

# 期中報告

班級:
組別:
組員學號: | 姓名 | 貢獻度(%)

合計100%
日期:

目錄

一、 | 主要設計概念 3
二、組員工作分配 | 4

三、預算規劃 5

四、進度規劃 6

五、進度報告 7

六、測試結果 8

七、系統設計分析驗證 | 9
八、加工零件簡圖與工序說明 | 10

九、參考文獻 11

1、 主要設計概念

二、組員工作分配

人員
任務項目

三、預算規劃

項目 | 單價 | 數量 | 金額 | 用途詳述

總金額：＿＿＿＿

其他現有資源:

四、進度規劃

Gantt chart
周次

項目

1 | 2 | 3 | 4 | 5 | 6 | 7 | 8 | 9 | 10 | 11 | 12 | 13 | 14 | 15 | 16 | 17

範例如下圖所示

五、進度報告

六、測試結果

七、系統設計分析驗證

八、加工零件簡圖與工序說明

九、參考文獻
