e14121040-netizen/2026-NCKU-ME-PROJECT/BOM.md

# 專題總零件清單 (BOM)

> 本文件為整個專題的統整零件清單，彙整取物機器人與運輸機器人兩台子系統的所有零件。  
> 各子系統的詳細 BOM 請見：
> - [取物機器人 BOM](取物機器人(八足Jansen)/BOM.md)
> - [運輸機器人 BOM](運輸機器人(EV3)/BOM.md)

---

## 一、取物機器人（八足 Theo Jansen）

### 電控系統

| 品項 | 規格 | 數量 | 單價 (NT$) | 小計 (NT$) | 狀態 |
|---|---|---|---|---|---|
| ESP32 開發板 | 雙核心 240MHz，內建 Wi-Fi/藍芽 | 1 | 189 | 189 | ✅ 已購 |
| ESP32-C3 開發板 | 單核心 RISC-V，ESP-NOW | 3 | 100 | 300 | 🔲 待購 |
| BTS7960 (IBT-2) 馬達驅動模組 | MOSFET H-Bridge，43A | 4 | 125 | 500 | 🔲 待購 |

### 馬達

| 品項 | 規格 | 數量 | 單價 (NT$) | 小計 (NT$) | 狀態 |
|---|---|---|---|---|---|
| JGB37-555 直流減速馬達 | DC 12V, 66 RPM | 2 | — | 0 | ✅ 現有 |
| XD-25GA 370 直流減速馬達 | 12V, 50 RPM（自鎖） | 1 | — | 0 | ✅ 現有 |
| JGY370 蝸桿減速馬達 | 12V，蝸桿自鎖 | 1 | — | 0 | ✅ 現有 |
| MG996R 伺服馬達（360° 連續旋轉） | 金屬齒輪，連續旋轉 | 1 | 120 | 120 | 🔲 待購 |
| MG996R 伺服馬達（180° 標準） | 金屬齒輪，高扭力 | 3 | 120 | 360 | 🔲 待購 |
| MG996R 舵機盤 | 25T 鋁合金圓型 | 4 | 35 | 140 | 🔲 待購 |

### 供電

| 品項 | 規格 | 數量 | 單價 (NT$) | 小計 (NT$) | 狀態 |
|---|---|---|---|---|---|
| 18650 松下鋰電池 | 3.7V，兩組 4S | 8 | 179 | 1,432 | ⚠ 已購 4，另需 4 |
| 4S BMS 保護板 | 4 串鋰電池保護，建議 ≥20A | 2 | 80 | 160 | 🔲 待購 |
| 鋰電池充電器 | | 1 | 100 | 100 | ✅ 已購 |
| 18650 四節電池盒 | 上半部 4S + 腿部 + FixedStage 4S | 2 | 28 | 56 | ⚠ 已購 1，另需 1 |
| 保險絲座 + 10A/15A 保險絲 | 汽車片式或線上型 | 2 | 50 | 100 | 🔲 待購 |
| 端子台 | 兩組電源各自正極 + GND 分配 | 4 | 40 | 160 | 🔲 待購 |
| 主電源開關 | DC ≥10A | 2 | 50 | 100 | 🔲 待購 |
| XL4015 降壓模組 | 可調輸出，最大 5A | 2 | 45 | 90 | 🔲 待購（上半部 Servo ×3 一路；Gate servo 一路） |
| LM2596 降壓模組 | 可調輸出，最大 3A | 2 | 30 | 60 | 🔲 待購（上半部 C3 #2 / 腿部 + FixedStage C3 #1/#3 分開） |
| 電解電容 | 1000μF 10V | 1 | 5 | 5 | 🔲 待購 |
| 陶瓷電容 | 100nF | 1 | 2 | 2 | 🔲 待購 |

> ⚠ 供電改為兩組 4S：上半部 4S 供 `C3 #2 + BTS7960 #4 + JGY370 z + 上方 Servo ×3`；腿部 + FixedStage 4S 供 `C3 #1/#3 + BTS7960 #1/#2/#3 + JGB37-555 ×2 + 固定端 spin + Gate servo`。

### 機構零件

| 品項 | 規格 | 數量 | 單價 (NT$) | 小計 (NT$) | 狀態 |
|---|---|---|---|---|---|
| 壓克力板 (3mm) | A4~A3 尺寸 | 4 | 50~100 | 200~400 | 🔲 待購 |
| 壓克力板 (5mm) | A4 尺寸 | 1 | 80 | 80 | 🔲 待購 |
| M3 螺絲/螺帽/墊圈 | 各包裝 | — | — | 120 | 🔲 待購 |
| 軸承 (3mm 內徑) | | 16 | 10 | 160 | 🔲 待購 |

### 夾爪 / 承物台

| 品項 | 規格 | 數量 | 單價 (NT$) | 小計 (NT$) | 狀態 |
|---|---|---|---|---|---|
| 齒條 | 配合雷切齒輪 | 2 | 50 | 100 | 🔲 待購 |
| 直線滑軌 MGN12 | | 1 | 200 | 200 | 🔲 待購 |
| 海綿 + 止滑墊 | | 各 1 | — | 50 | 🔲 待購 |
| 絞鏈 + 伸縮桿 | | 各 2/1 | — | 50 | 🔲 待購 |
| 承物台板材 | 壓克力 3mm | 1 | 60 | 60 | 🔲 待購 |

### 連接線材 / 工具

| 品項 | 規格 | 數量 | 單價 (NT$) | 小計 (NT$) | 狀態 |
|---|---|---|---|---|---|
| 杜邦線 (公母) | | 1 | 37 | 37 | ✅ 已購 |
| 杜邦線 + 電源線 + 電阻 | 含 16/18/20/22AWG 矽膠線 | — | — | 92 | 🔲 待購 |
| ABS 3D 列印線材 | | 1 | 369 | 369 | ✅ 已購 |
| WD-40 | | 1 | 188 | 188 | ✅ 已購 |
| 活動板手 | | 1 | 95 | 95 | ✅ 已購 |

---

## 二、運輸機器人（EV3）

### EV3 套件（學校借用）

| 品項 | 數量 | 說明 | 狀態 |
|---|---|---|---|
| EV3 Brick 主控 | 1 | 主控電腦 | ✅ 借用 |
| EV3 大馬達 | 2 | 左右輪驅動 (Port D, C) | ✅ 借用 |
| EV3 中馬達 | 1 | 輸送帶驅動 (Port A) | ✅ 借用 |
| EV3 顏色感測器 | 1 | 循跡與停止線偵測 (S1) | ✅ 借用 |
| EV3 觸碰感測器 | 1 | 啟動/零件偵測 (S4) | ✅ 借用 |
| EV3 連接線 | ≥5 條 | 馬達 ×3 + 感測器 ×2 | ✅ 借用 |
| LEGO 結構件 | 若干 | 底盤、支架、齒輪 | ✅ 借用 |
| LEGO 大輪 | 2 | 直徑 56mm | ✅ 借用 |
| 萬向輪/支撐輪 | 1 | 或用 LEGO 球輪 | ✅ 借用 |
| LEGO 履帶組 | 1 組 | 頂部水平輸送帶 | ✅ 借用 |

### 額外消耗品

| 品項 | 規格 | 數量 | 單價 (NT$) | 小計 (NT$) | 狀態 |
|---|---|---|---|---|---|
| microSD 卡 | ≥16GB, Class 10 | 1 | 100 | 100 | 🔲 待購 |
| USB 線 (Mini-B) | | 1 | 50 | 50 | 🔲 待購 |

| AA 充電電池 | 1.2V NiMH | 6 | 40 | 240 | 🔲 待購 |

---

## 三、總預算匯總

| 類別 | 估算金額 (NT$) |
|---|---|
| 取物機器人 — 電控系統 | ~989 |
| 取物機器人 — 馬達 | ~620 |
| 取物機器人 — 供電 | ~1,231 |
| 取物機器人 — 機構零件 | ~560~760 |
| 取物機器人 — 夾爪/承物台 | ~500 |
| 取物機器人 — 線材/工具 | ~781 |
| **取物機器人小計** | **~4,681~4,881** |
| | |
| 運輸機器人 — EV3 套件 | 0（學校借用） |
| 運輸機器人 — 額外消耗品 | ~390 |
| **運輸機器人小計** | **~390** |
| | |
| **專題總計** | **~5,071~5,271** |

> ⚠ 目前 BOM 已按兩組 4S 計算；若後續擴充第 3 組，需額外增加約 NT$744（電池 + 電池盒，未含 BMS/保險絲）。

---

## 四、經費執行情況（截至 2026/03/29）

| 品項 | 採買日期 | 數量 | 單價 (NT$) | 總價 (NT$) |
|---|---|---|---|---|
| WD-40 | 2026/03/02 | 1 | 188 | 188 |
| 活動板手 | 2026/03/02 | 1 | 95 | 95 |
| 18650 松下鋰電池 | 2026/03/14 | 4 | 179 | 716 |
| 鋰電池充電器 | 2026/03/14 | 1 | 100 | 100 |
| 18650 四節電池盒 | 2026/03/14 | 1 | 28 | 28 |
| ESP32 開發板 | 2026/03/14 | 1 | 189 | 189 |
| 杜邦線 | 2026/03/14 | 1 | 37 | 37 |
| ABS 3D 列印線材 | 2026/03/23 | 1 | 369 | 369 |
| 運費 | 2026/03/23 | 1 | 45 | 45 |
| **已花費合計** | | | | **1,767** |

| 項目 | 金額 (NT$) |
|---|---|
| 總經費 | 10,000 |
| 已花費 | 1,767 |
| 剩餘經費 | 8,233 |
| 經費使用率 | 17.67% |
