e14121040-netizen/2026-NCKU-ME-PROJECT/取物機器人(八足Jansen)/BOM.md

# 取物機器人 — 零件清單 (BOM)

> 以下為八足 Theo Jansen 取物機器人所需的零件清單。  
> 價格為估算，請依實際通路（露天、蝦皮、光華商場）查詢。  
> ⚠ **最後更新：2026/06/10** — 供電改為上半部 4S 與腿部 + FixedStage 4S 兩組電池。

## 電控系統

| 品項 | 規格 | 數量 | 單價 (NT$) | 小計 (NT$) | 備註 |
|---|---|---|---|---|---|
| ESP32 開發板 | 雙核心 240MHz，內建 Wi-Fi/藍芽 | 1 | 189 | 189 | 主控板（藍芽接收/ESP-NOW 指令分發），USB 插電腦供電 |
| ESP32-C3 開發板 | 單核心 RISC-V，ESP-NOW | 3 | 100 | 300 | #1 腿部 / #2 RotatingArm / #3 FixedStage |
| BTS7960 (IBT-2) 馬達驅動模組 | MOSFET H-Bridge，43A | 4 | 125 | 500 | 腿部步行馬達（左右各 1）+ FixedStage spin + z 升降 |

## 馬達

| 品項 | 規格 | 數量 | 單價 (NT$) | 小計 (NT$) | 備註 |
|---|---|---|---|---|---|
| JGB37-555 直流減速馬達 | DC 12V, 66 RPM | 2 | — | 0 (現有) | 腿部步行主力：左右各 1 顆，原地旋轉轉向 |
| XD-25GA 370 直流減速馬達 | 12V, 50 RPM（自鎖） | 1 | — | 0 (現有) | 夾爪底部大圓盤旋轉 |
| JGY370 蝸桿減速馬達 | 12V，蝸桿自鎖 | 1 | — | 0 (現有) | z 方向升降，自鎖防止斷電下滑 |
| MG996R 伺服馬達（360° 連續旋轉） | 金屬齒輪，連續旋轉 | 1 | 120 | 120 | r 方向齒條伸縮（人眼判斷位置） |
| MG996R 伺服馬達（180° 標準） | 金屬齒輪，高扭力 | 3 | 120 | 360 | 夾爪 θ 旋轉 + 夾爪開合 + 承物盒擋板 |
| MG996R 舵機盤 | 25T 鋁合金圓型 | 4 | 35 | 140 | 搭配 MG996R 使用（含 360° 齒條齒輪用 + 擋板用） |

## 供電

| 品項 | 規格 | 數量 | 單價 (NT$) | 小計 (NT$) | 備註 |
|---|---|---|---|---|---|
| 18650 松下鋰電池 | 3.7V，兩組 4S | 8 | 179 | 1,432 | 上半部 4S + 腿部 + FixedStage 4S |
| 4S BMS 保護板 | 4 串鋰電池保護，建議 ≥20A | 2 | 80 | 160 | 每組 4S 各 1 片，過充、過放、過流保護 |
| 鋰電池充電器 | | 1 | 100 | 100 | 電源供應補充 |
| 18650 四節電池盒 | | 2 | 28 | 56 | 上半部 4S + 腿部 + FixedStage 4S |
| 保險絲座 + 10A/15A 保險絲 | 汽車片式或線上型 | 2 | 50 | 100 | 兩組電池正極出口各 1 組 |
| 端子台 | 兩組電源各自正極 + GND 分配 | 4 | 40 | 160 | 上半部與腿部 + FixedStage 分開星形分配 |
| 主電源開關 | DC ≥10A | 2 | 50 | 100 | 兩組電池獨立上電/斷電 |
| XL4015 降壓模組 | 可調輸出，最大 **5A** | 2 | 45 | 90 | **Servo 專用 5V 電源**（上半部 Servo ×3 一路；Gate servo 一路） |
| LM2596 降壓模組 | 可調輸出，最大 3A | 2 | 30 | 60 | **MCU 專用 5V 電源**（上半部 C3 #2 / 腿部 + FixedStage C3 #1/#3 分開） |
| 電解電容 | 1000μF 10V | 1 | 5 | 5 | 並聯在 XL4015 輸出端，吸收 Servo 突波 |
| 陶瓷電容 | 100nF (0.1μF) | 1 | 2 | 2 | 高頻雜訊濾波，與電解電容並聯 |

> ⚠ 供電改為兩組 4S：上半部 4S 供 `C3 #2 + BTS7960 #4 + JGY370 z + 上方 Servo ×3`；腿部 + FixedStage 4S 供 `C3 #1/#3 + BTS7960 #1/#2/#3 + JGB37-555 ×2 + 固定端 spin + Gate servo`。

## 機構零件

| 品項 | 規格 | 數量 | 單價 (NT$) | 小計 (NT$) | 備註 |
|---|---|---|---|---|---|
| 壓克力板 (3mm) | A4~A3 尺寸 | 4 | 50~100 | 200~400 | 連桿片雷射切割（八足需大量） |
| 壓克力板 (5mm) | A4 尺寸 | 1 | 80 | 80 | 底盤結構 |
| M3 螺絲/螺帽/墊圈 | | 各包裝 | — | 120 | 連桿軸銷及組裝固定 |
| 軸承 (3mm 內徑) | | 16 | 10 | 160 | 八足曲柄軸用，減少摩擦 |

## 夾爪 / 承物台材料

| 品項 | 規格 | 數量 | 單價 (NT$) | 小計 (NT$) | 備註 |
|---|---|---|---|---|---|
| 齒條 | 配合雷切齒輪 | 2 | 50 | 100 | 夾爪線性運動 + r 方向伸縮 |
| 直線滑軌 MGN12 | | 1 | 200 | 200 | 手臂線性伸縮軌道（r 齒條導引） |
| 海綿 + 止滑墊 | | 各 1 | — | 50 | 夾爪內側增加摩擦力 |
| 絞鏈 + 伸縮桿 | | 各 2/1 | — | 50 | 承物台傾斜機構 |
| 承物台板材 | 壓克力 3mm | 1 | 60 | 60 | 承物台結構 |

## 連接線材 / 工具

| 品項 | 規格 | 數量 | 單價 (NT$) | 小計 (NT$) | 備註 |
|---|---|---|---|---|---|
| 杜邦線 (公母) | | 1 | 37 | 37 | 控制板與馬達連結 |
| 杜邦線 + 電源線 + 電阻 | 含 16/18/20/22AWG 矽膠線 | — | — | 92 | 信號線與電源線分開使用；腿部 + FixedStage 電池主幹建議 16AWG |
| WD-40 | | 1 | 188 | 188 | 拆解時除膠與腿部潤滑 |
| 活動板手 | | 1 | 95 | 95 | 拆卸與組裝機器人工具 |

## 目前實際採買紀錄（截至 2026/03/29）

> 以下為目前已完成採買的電控零件、工具與製作耗材，主要用於取物機器人原型開發與整體組裝測試。

| 品項 | 採買日期 | 採買數量 | 單價 (NT$) | 總價格 (NT$) |
|---|---|---|---|---|
| WD-40 | 2026/03/02 | 1 | 188 | 188 |
| 活動板手 | 2026/03/02 | 1 | 95 | 95 |
| 18650 松下鋰電池 | 2026/03/14 | 4 | 179 | 716 |
| 鋰電池充電器 | 2026/03/14 | 1 | 100 | 100 |
| 18650 四節電池盒 | 2026/03/14 | 1 | 28 | 28 |
| ESP32 開發版 | 2026/03/14 | 1 | 189 | 189 |
| 杜邦線 | 2026/03/14 | 1 | 37 | 37 |
| ABS 3D 列印線材 | 2026/03/23 | 1 | 369 | 369 |
| 運費 | 2026/03/23 | 1 | 45 | 45 |
| **合計** |  |  |  | **1,767** |

| 項目 | 金額 (NT$) |
|---|---|
| 目前總經費 | 10,000 |
| 目前已花費 | 1,767 |
| 剩餘經費 | 8,233 |
| 經費使用率 | 17.67% |
