e14121040-netizen/2026-NCKU-ME-PROJECT/運輸機器人(EV3)/BOM.md

# 運輸機器人 — 零件清單 (BOM)

> EV3 機器人的零件大多為 LEGO EV3 教具套件，由學校提供借用。  
> 以下列出所需零件與額外消耗品。

## EV3 套件零件（學校借用）

| 品項 | 數量 | 說明 |
|---|---|---|
| EV3 Brick 主控 | 1 | 主控電腦 |
| EV3 大馬達 | 2 | 左右輪驅動 (Port D, C) |
| EV3 中馬達 | 1 | 輸送帶驅動 (Port A) |
| EV3 顏色感測器 | 1 | 循跡與停止線偵測 (S1) |
| EV3 觸碰感測器 | 1 | 啟動/零件偵測 (S4) |
| EV3 連接線 | ≥5 條 | 馬達 ×3 + 感測器 ×2 |
| LEGO 結構件 | 若干 | 底盤、支架、齒輪 |
| LEGO 大輪 | 2 | 直徑 56mm |
| 萬向輪/支撐輪 | 1 | 或用 LEGO 球輪 |
| LEGO 履帶組 | 1 組 | 頂部水平輸送帶（履帶片 + 驅動輪 + 惰輪） |

## 額外消耗品

| 品項 | 規格 | 數量 | 單價 (NT$) | 備註 |
|---|---|---|---|---|
| microSD 卡 | ≥16GB, Class 10 | 1 | 100 | 安裝 ev3dev / Pybricks |
| USB 線 (Mini-B) | | 1 | 50 | 連接 EV3 到電腦 |
| 黑色電氣膠帶 | 寬 19mm | 1 卷 | 30 | 場地軌跡線 |
| 黃色色紙 / 膠帶 | | 適量 | 20 | 放置區停止線 |
| 紅色色紙 / 膠帶 | | 適量 | 20 | 起點停止線 |
| AA 電池 (充電式) | 1.2V NiMH | 6 | 40/顆 | EV3 Brick 供電 |

## 預算總結

| 類別 | 估算 (NT$) |
|---|---|
| EV3 套件 | 0（學校借用） |
| 額外消耗品 | ~460 |
| **合計** | **~460** |

> 截至 2026/03/29，專題整體已實際採買 1,767 元，內容以取物機器人原型所需的電控零件、電池模組、工具與製作耗材為主。
> 運輸機器人目前仍以學校借用的 EV3 套件進行開發，尚無額外 EV3 專屬採買支出。
