e14121040-netizen/2026-NCKU-ME-PROJECT/esp32控制/00_macaddress/00_macaddress.ino

#include <WiFi.h>

void setup() {
  // put your setup code here, to run once:
  Serial.begin(115200);
  delay(1000);

  WiFi.mode(WIFI_STA);
  Serial.print("ESP32-C3 MAC Address: ");
  Serial.println(WiFi.macAddress());
}

void loop() {
  // put your main code here, to run repeatedly:
    Serial.print("ESP32-C3 MAC Address: ");
    Serial.println(WiFi.macAddress());
    delay(2000);
}
