e14121040-netizen/2026-NCKU-ME-PROJECT/(commit log)

2026-02-24 docs: update project README.
    [機專收支Github用.xlsx]
2026-02-27 docs: Add Arduino development workflow documentation for Apple Silicon Macs
2026-02-27 docs: Clarify Arduino workflow is macOS-only with Windows guidance and add `.agent/` to gitignore.
2026-03-01 docs: 更新 README.md 檔案。
2026-03-04 chore: 從 .gitignore 中移除 .clangd
2026-03-10 chore: 刪除一個未指定的文件。
2026-03-24 EV3 PID (failed)
2026-03-31 新增運輸機器人的測試版本
2026-03-31 更新大量文件
2026-03-31 新增總bom表
2026-03-31 新增馬達零件
2026-04-07 esp32控制
2026-04-12 C3腿部 & 主控版腿部指令
2026-04-14 夾爪角度和r控制
2026-04-14 refactor: 電控升級為 3×ESP32-C3 分散式架構，腿部馬達獨立子控板
2026-04-14 更新windows流程
2026-04-18 腿部連線修改(v1)
2026-04-21 feat: 新增 ZClawController、MainController_BLE，修復 merge conflict
2026-04-21 docs: 全面同步文件與程式碼，修正指令表不一致、移除 PCA9685 殘留
    - fix: 統一所有指令表為圓柱座標格式 (w/s/a/d + u/j/o/p/t/y/h)
    - fix: 移除所有文件中的 PCA9685 參考，改為 ESP32-C3 GPIO PWM
    - feat: 新增 esp32控制/protocol.h 共用通訊協議定義
    - feat: MainController 新增 MAC 地址佔位符啟動警告
    - feat: MainController_BLE 補完 SPD:xxx 速度設定功能
    - docs: 主 README 目錄結構新增 esp32控制/ 區塊
    - docs: 更新開發進度 checklist 反映當前狀態
    - docs: esp32控制/README.md 新增版本需求與已知限制
    - docs: 取物機器人 README 快速開始加入 esp32控制/ 連結
    - docs: 新增開會紀錄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
    [MainController_BLE.ino, protocol.h]
2026-04-28 LEG modification(can move)
2026-05-05 更新專案架構
2026-05-05 更新電控內容
2026-05-06 腿部馬達驅動從 L298N 升級為 BTS7960
2026-05-06 更新文件
2026-05-12 接線更新
2026-05-15 mermaid 新增
2026-05-15 mermaid_ev3新增
2026-05-15 Remove Power configuration section from diagram
    Removed the Power subgraph from the EV3 diagram.
2026-05-15 mermaid_ev3_code新增
2026-05-19 docs: update project README and bill of materials documentation
2026-05-24 fix: unify esp32 BLE control flow
    [01_MainController.ino, 02_LegController.ino, protocol.h, verify_esp32_mobile_control_consistency.py]
2026-05-24 Fix comments/naming and resolve undetected static analysis errors.
    [transport_robot.py]
2026-05-26 更新mac地址
2026-05-26 移除限位開關
2026-05-26 更新腳位
2026-05-26 Update transport_robot.py - 減少從放置區起步後未能正確循線的機率 - 雜項註釋修正
    [transport_robot.py]
2026-05-26 Update ev3_pid_simulation.m - 同步公式
2026-05-28 add automated consistency verification script for ESP32 control logic and project documentation
2026-06-02 docs: update README and BOM documentation to reflect project changes
2026-06-02 feat: add verification for lazy servo attachment and prevent unwanted initialization in setup()
    [verify_esp32_mobile_control_consistency.py]
2026-06-02 feat: add consistency verification for GPIO 0 servo attachment and emergency stop detachment logic
2026-06-02 feat: add validation rules for gate servo control logic and normalized BLE command parsing
2026-06-02 feat: add validation for Theta+/Theta- BLE text aliases in ESP32 control verification script
2026-06-04 feat: add consistency verification for GPIO 1 theta servo lazy attachment and detachment logic
2026-06-06 feat: add RSTOP command verification and update Turntable Z MAC address in ESP32 consistency checker
2026-06-06 feat: split rotating arm and fixed stage controllers
    [01_MainController.ino, 03_RotatingArmController.ino, 04_FixedStageController.ino, protocol.h, verify_esp32_mobile_control_consistency.py]
2026-06-09 Update transport_robot.py - 從紅線上啟動前等待5秒
2026-06-09 feat: add validation for servo constants and Z-axis speed control in consistency check script
2026-06-09 feat: update consistency verifier to support unsigned long constants and enforce standard servo PWM hold logic
2026-06-09 feat: update consistency verifier to enforce non-blocking claw ramp motion logic
2026-06-09 refactor: update claw control constants to optimize soft closing and movement speed
2026-06-09 refactor: update rack servo control constants to 23 and 157 for optimized speed adjustment
2026-06-09 Update transport_robot.py - 遇到黃線時額外前進一段距離 - 改進初始化失敗時的錯誤處理
2026-06-10 fix: slow and correct rack servo direction
    [03_RotatingArmController.ino, verify_esp32_mobile_control_consistency.py]
2026-06-10 test: update verification script to enforce FIXED_SPIN_DEFAULT_SPEED usage in fixed stage control
    [01_MainController.ino, 04_FixedStageController.ino, protocol.h, verify_esp32_mobile_control_consistency.py]
2026-06-10 chore: update fixed spin speed to 156 and add GATE_RUN_TIME_MS requirement to verification tool
    [04_FixedStageController.ino, protocol.h, verify_esp32_mobile_control_consistency.py]
2026-06-11 change the esp32 c3 leg controller
2026-06-11 fix: update documentation and verify power distribution consistency for 4S battery grouping and FixedStage loads
    [02_LegController.ino, verify_esp32_mobile_control_consistency.py]
2026-06-15 feat: add test script to verify leg motor trim implementation in LegController.ino
2026-06-15 fix: hold fixed gate close position
    [04_FixedStageController.ino]
2026-06-15 refactor: update CLAW_CLOSE_ANGLE verification target from 140 to 160 in ESP32 control consistency check
2026-06-15 chore: remove redundant verification tool and update CLAW_CLOSE_ANGLE requirement to 170
2026-06-24 docs: update mermaid diagram to match current architecture
2026-06-24 docs: split control and power mermaid diagrams, simplify master block
